ckrajkumar/nic2025_openDVS/analog/klayout/production/final_merge_20260923/audit_20260924/AUDIT_r21b_2026-09-24.md

# Audit of the submitted GDS r21b (sha fe196d31…) — 2026-09-24

Scope: full-layer XOR vs the collaborators' original (project_final), Magic DRC per rule, native FEOL/BEOL/offgrid,
metal-only connectivity of every analog macro pin vs gate-level verilog (r21b + original), LVS mismatch
classification with a baseline LVS of the untouched original + its own reference netlists. No GDS changed, no mail.
Scratch: ws ~/opendvs_final/audit_{lvs,conn,drc}/, project_audit_orig/.

## Changes vs original (XOR, 65 layers + labels, hierarchical + flat)
Only three sources, nothing else anywhere (0 polygons, 0 labels):
- pixel_4tile subtree (9 cells) + pixel_test_structure (2 cells): r19 pixel merge. 3 cells dropped (m1_m2_density_tile, vias_gen$3/$4).
- top met4 ×20 stripes / met5 ×20 stubs: r20 power joins.
- top via2 + met2 pad at 403.4–403.77 × 2622.28–2622.56: r21b rx fix.
Placements, cell count of the rest, layers: identical.

## Issues
| # | Issue | Where | Source | Severity | Action |
|---|---|---|---|---|---|
| 1 | rx (master-bias reference) floating | BiasBranchnMasterx11 rx, 404.35,2622.95 | collaborators' router | critical | fixed in r21b |
| 2 | Magic DRC 77 769 (r19) → 180 025 (r21b); all new items in pixel_4tile edge bands where r20 met4/met5 enter the tile bbox (abut/overlap 117 658, li.3, met1/2/3/5.2, capm.11) | pixel_4tile y 728–800 / 2200–2261, x 1212–1330 / 2630–2743 | us (r20) — Magic hierarchical artefact | low (real geometry), medium (optics if ChipFoundry reports Magic counts) | 280 sampled items: 0 real in flat KLayout; native BEOL deck 0. If flagged, answer with KLayout deck 0; optional flat Magic DRC of the bands |
| 3 | FEOL licon.17 + licon.13_a, 3528 items under KLayout 0.30 | GS_pixel_layout_tile(_bot) periphery | collaborators (identical in original; 0 under precheck's KLayout 0.29) | info | none |
| 4 | orphan `nRst` met1 label (no met1 under it) in every pixel | GS_openDVS_pixel (10.22,6.13); S7_openDVS_pixel | us (r19) | low (LVS unaffected) | delete in any future revision |
| 5 | `GND` met2 label off its met2.pin | GS_pixel_layout_tile_bot (2.82,15.67) | us (r19 row feeds) | low | same |
| 6 | stray labels on unconnected metal: BiasCB4, BufferN | LJ_BiasCoarseMBDivider, LJ_BiasBranch(Buffer) | collaborators | low (causes LVS lines) | none |
| 7 | labels vdda1/vssa1 on vdda2/vssa2 metal | photodiode_test_structure 276.14,1031.55 / 273.44,1031.12 | collaborators | low (no short) | none |
| 8 | Bias[10] unconnected | BiasBranchnMasterx11 593.58,3188.90 | design (dac_bias[10] unused) | info | none |
| 9 | repo LVS reference netlists = old pixel (.orig) | nic repo lvs/user_project_wrapper/ | collaborators' repo | medium (process: any LVS rerun from their repo fails on the pixel) | replace with our pixel_4tile/test-structure netlists |
| 10 | antenna (Magic antennacheck, PDK ratios, 220 600 gates) | r21b 14 violations = 9 met1 + 4 met2 + 1 met3, all on digital std-cell gates (ratios 428–854, limit 400), item-for-item identical to the original | collaborators' digital P&R | low–medium (pre-existing, their flow; typical sky130 ratio margins) | none from us; original also had 2 met3 violations on the test-structure pixels (openDVS_pixel_1/_2 at ~567,1041 µm, ratio 802/853) that r21b no longer has — removed by our pixel |

## LVS (114 Mismatch lines) — all benign
Baseline (original GDS + its reference netlists): same "Subcell(s) failed matching", 116 lines, same 16 groups.
- pixel/2x2/tile net counts: hierarchy-boundary splits (VddA18 on X14 source, 34 DiffBn tile ports → dac_config_0); flattened pixel_4tile + test structure match uniquely.
- pixel_4tile vssc1/vdda1/VSUBS: naming; 376 960 devices / 181 264 nets both sides.
- LJ_Bias*: topology-paired port names + stray labels (#6). BiasBranchnMasterx11 452/453: BiasCB4 piece; flat netgen match uniquely.
- top 28 814 vs 29 262 nets + ~70 port lines: implicit unconnected outputs, tie-off pairing; pin map of 48 751 instances vs verilog: 0 differences.
- vssa1/vssa2/vssd1 merged through the p-substrate in the Magic extraction (baseline too; separate in metal).
- pixel_4tile vs SCHEMATIC: ini ~/netgen_r19/comp.out "Circuits match uniquely"; r21b tile subtree identical to that r19 tile.

## Connectivity
1216 macro pin connections vs verilog: only defect in either GDS = #1. 8 power nets each single, no shorts, all macro rails reached.
