ckrajkumar/nic2025_openDVS/analog/klayout/production/final_merge_20260923/r19/power_sw_zoom.png

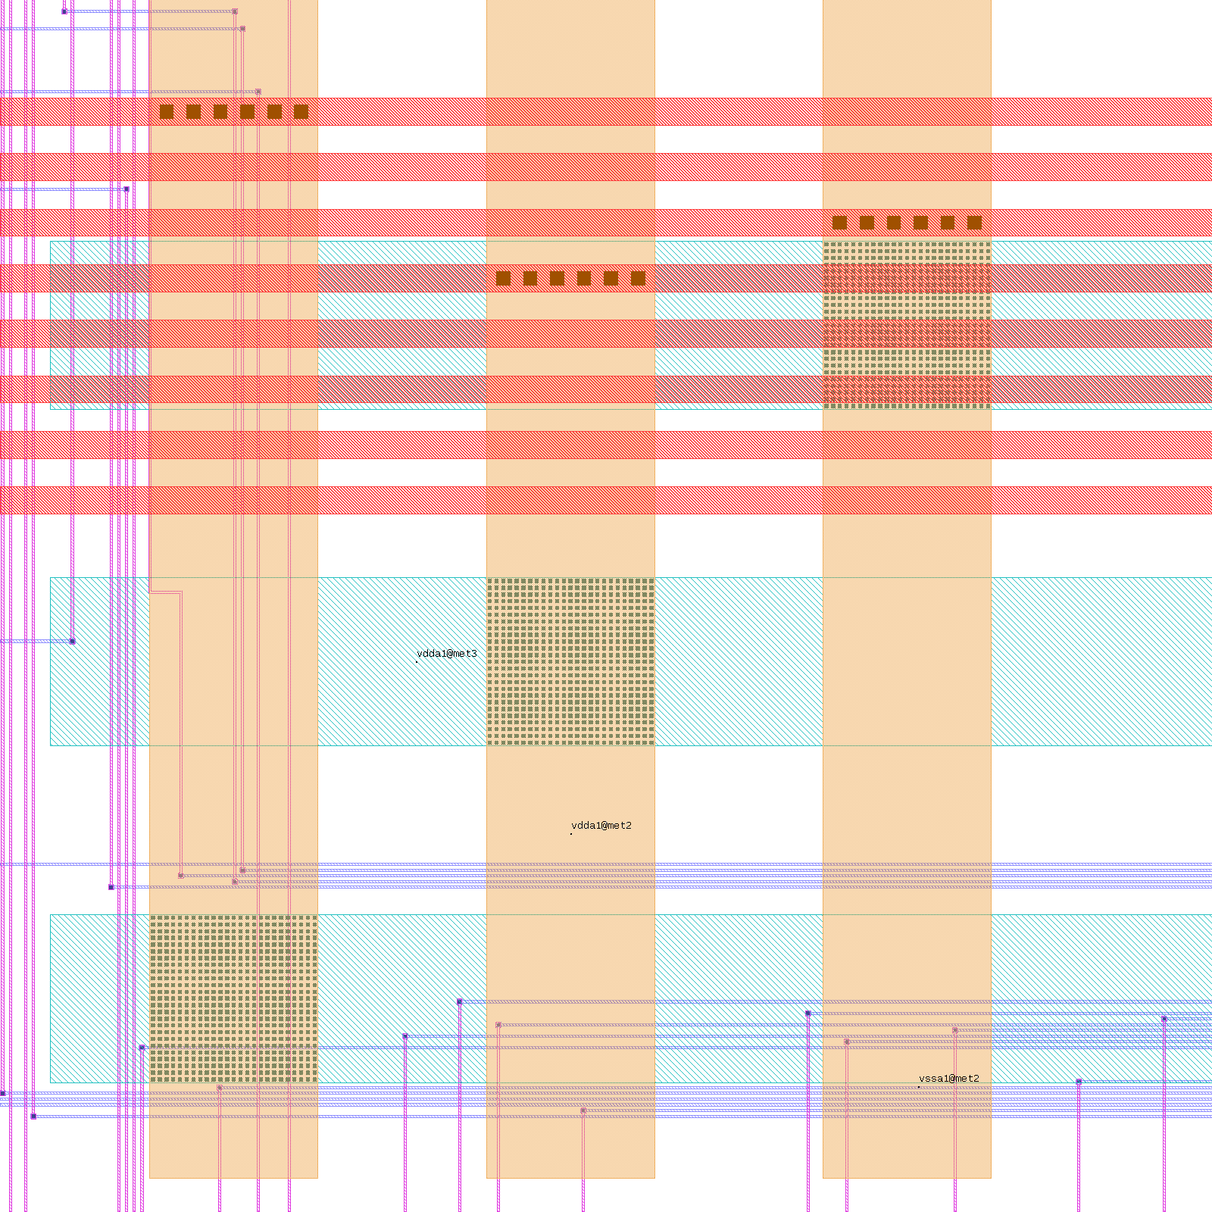
analog/klayout/production/final_merge_20260923/r19/power_sw_zoom.png
