ckrajkumar/nic2025_openDVS/analog/netlist/schematic/lvs_runs/_tmp/BiasBranchnMasterx11_schem_lvs_renamed.spice

** sch_path: /home/alienfalcon/Projects/skywater/open_dvs_py312/open_dvs/git_dvs/nic2025_openDVS/analog/xschem/BiasBranchnMasterx11_layout.sch
.subckt BiasBranchnMasterx11_schem VddA18 GndA rx Bias[10] Bias[9] Bias[8] Bias[7] Bias[6] Bias[5] Bias[4] Bias[3] Bias[2]
+ Bias[1] Bias[0] FineCodeBuffer[7] FineCodeBuffer[6] FineCodeBuffer[5] FineCodeBuffer[4] FineCodeBuffer[3] FineCodeBuffer[2]
+ FineCodeBuffer[1] FineCodeBuffer[0] CoarseOneHot[87] CoarseOneHot[86] CoarseOneHot[85] CoarseOneHot[84] CoarseOneHot[83] CoarseOneHot[82]
+ CoarseOneHot[81] CoarseOneHot[80] CoarseOneHot[79] CoarseOneHot[78] CoarseOneHot[77] CoarseOneHot[76] CoarseOneHot[75] CoarseOneHot[74]
+ CoarseOneHot[73] CoarseOneHot[72] CoarseOneHot[71] CoarseOneHot[70] CoarseOneHot[69] CoarseOneHot[68] CoarseOneHot[67] CoarseOneHot[66]
+ CoarseOneHot[65] CoarseOneHot[64] CoarseOneHot[63] CoarseOneHot[62] CoarseOneHot[61] CoarseOneHot[60] CoarseOneHot[59] CoarseOneHot[58]
+ CoarseOneHot[57] CoarseOneHot[56] CoarseOneHot[55] CoarseOneHot[54] CoarseOneHot[53] CoarseOneHot[52] CoarseOneHot[51] CoarseOneHot[50]
+ CoarseOneHot[49] CoarseOneHot[48] CoarseOneHot[47] CoarseOneHot[46] CoarseOneHot[45] CoarseOneHot[44] CoarseOneHot[43] CoarseOneHot[42]
+ CoarseOneHot[41] CoarseOneHot[40] CoarseOneHot[39] CoarseOneHot[38] CoarseOneHot[37] CoarseOneHot[36] CoarseOneHot[35] CoarseOneHot[34]
+ CoarseOneHot[33] CoarseOneHot[32] CoarseOneHot[31] CoarseOneHot[30] CoarseOneHot[29] CoarseOneHot[28] CoarseOneHot[27] CoarseOneHot[26]
+ CoarseOneHot[25] CoarseOneHot[24] CoarseOneHot[23] CoarseOneHot[22] CoarseOneHot[21] CoarseOneHot[20] CoarseOneHot[19] CoarseOneHot[18]
+ CoarseOneHot[17] CoarseOneHot[16] CoarseOneHot[15] CoarseOneHot[14] CoarseOneHot[13] CoarseOneHot[12] CoarseOneHot[11] CoarseOneHot[10]
+ CoarseOneHot[9] CoarseOneHot[8] CoarseOneHot[7] CoarseOneHot[6] CoarseOneHot[5] CoarseOneHot[4] CoarseOneHot[3] CoarseOneHot[2] CoarseOneHot[1]
+ CoarseOneHot[0] nFineCodeBuffer[7] nFineCodeBuffer[6] nFineCodeBuffer[5] nFineCodeBuffer[4] nFineCodeBuffer[3] nFineCodeBuffer[2]
+ nFineCodeBuffer[1] nFineCodeBuffer[0] CoarseOneHotBuffer[7] CoarseOneHotBuffer[6] CoarseOneHotBuffer[5] CoarseOneHotBuffer[4] CoarseOneHotBuffer[3]
+ CoarseOneHotBuffer[2] CoarseOneHotBuffer[1] CoarseOneHotBuffer[0] LowBiasInterfaceEn[10] LowBiasInterfaceEn[9] LowBiasInterfaceEn[8]
+ LowBiasInterfaceEn[7] LowBiasInterfaceEn[6] LowBiasInterfaceEn[5] LowBiasInterfaceEn[4] LowBiasInterfaceEn[3] LowBiasInterfaceEn[2]
+ LowBiasInterfaceEn[1] LowBiasInterfaceEn[0] nLowBiasInterfaceEn[10] nLowBiasInterfaceEn[9] nLowBiasInterfaceEn[8] nLowBiasInterfaceEn[7]
+ nLowBiasInterfaceEn[6] nLowBiasInterfaceEn[5] nLowBiasInterfaceEn[4] nLowBiasInterfaceEn[3] nLowBiasInterfaceEn[2] nLowBiasInterfaceEn[1]
+ nLowBiasInterfaceEn[0] CoarseOneHotLowBiasEn[10] CoarseOneHotLowBiasEn[9] CoarseOneHotLowBiasEn[8] CoarseOneHotLowBiasEn[7] CoarseOneHotLowBiasEn[6]
+ CoarseOneHotLowBiasEn[5] CoarseOneHotLowBiasEn[4] CoarseOneHotLowBiasEn[3] CoarseOneHotLowBiasEn[2] CoarseOneHotLowBiasEn[1] CoarseOneHotLowBiasEn[0]
+ BIT0[10] BIT0[9] BIT0[8] BIT0[7] BIT0[6] BIT0[5] BIT0[4] BIT0[3] BIT0[2] BIT0[1] BIT0[0] PowerDown[10] PowerDown[9] PowerDown[8]
+ PowerDown[7] PowerDown[6] PowerDown[5] PowerDown[4] PowerDown[3] PowerDown[2] PowerDown[1] PowerDown[0] LowBiasInterfaceEnBuffer
+ nLowBiasInterfaceEnBuffer CoarseOneHotLowBiasEnBuffer PowerDownM NBiasEn[10] NBiasEn[9] NBiasEn[8] NBiasEn[7] NBiasEn[6] NBiasEn[5] NBiasEn[4] NBiasEn[3]
+ NBiasEn[2] NBiasEn[1] NBiasEn[0] PBiasEn[10] PBiasEn[9] PBiasEn[8] PBiasEn[7] PBiasEn[6] PBiasEn[5] PBiasEn[4] PBiasEn[3] PBiasEn[2]
+ PBiasEn[1] PBiasEn[0] BiasDisabled[10] BiasDisabled[9] BiasDisabled[8] BiasDisabled[7] BiasDisabled[6] BiasDisabled[5] BiasDisabled[4]
+ BiasDisabled[3] BiasDisabled[2] BiasDisabled[1] BiasDisabled[0] FineCode[87] FineCode[86] FineCode[85] FineCode[84] FineCode[83] FineCode[82]
+ FineCode[81] FineCode[80] FineCode[79] FineCode[78] FineCode[77] FineCode[76] FineCode[75] FineCode[74] FineCode[73] FineCode[72] FineCode[71]
+ FineCode[70] FineCode[69] FineCode[68] FineCode[67] FineCode[66] FineCode[65] FineCode[64] FineCode[63] FineCode[62] FineCode[61] FineCode[60]
+ FineCode[59] FineCode[58] FineCode[57] FineCode[56] FineCode[55] FineCode[54] FineCode[53] FineCode[52] FineCode[51] FineCode[50] FineCode[49]
+ FineCode[48] FineCode[47] FineCode[46] FineCode[45] FineCode[44] FineCode[43] FineCode[42] FineCode[41] FineCode[40] FineCode[39] FineCode[38]
+ FineCode[37] FineCode[36] FineCode[35] FineCode[34] FineCode[33] FineCode[32] FineCode[31] FineCode[30] FineCode[29] FineCode[28] FineCode[27]
+ FineCode[26] FineCode[25] FineCode[24] FineCode[23] FineCode[22] FineCode[21] FineCode[20] FineCode[19] FineCode[18] FineCode[17] FineCode[16]
+ FineCode[15] FineCode[14] FineCode[13] FineCode[12] FineCode[11] FineCode[10] FineCode[9] FineCode[8] FineCode[7] FineCode[6] FineCode[5]
+ FineCode[4] FineCode[3] FineCode[2] FineCode[1] FineCode[0] nFineCode[87] nFineCode[86] nFineCode[85] nFineCode[84] nFineCode[83]
+ nFineCode[82] nFineCode[81] nFineCode[80] nFineCode[79] nFineCode[78] nFineCode[77] nFineCode[76] nFineCode[75] nFineCode[74] nFineCode[73]
+ nFineCode[72] nFineCode[71] nFineCode[70] nFineCode[69] nFineCode[68] nFineCode[67] nFineCode[66] nFineCode[65] nFineCode[64] nFineCode[63]
+ nFineCode[62] nFineCode[61] nFineCode[60] nFineCode[59] nFineCode[58] nFineCode[57] nFineCode[56] nFineCode[55] nFineCode[54] nFineCode[53]
+ nFineCode[52] nFineCode[51] nFineCode[50] nFineCode[49] nFineCode[48] nFineCode[47] nFineCode[46] nFineCode[45] nFineCode[44] nFineCode[43]
+ nFineCode[42] nFineCode[41] nFineCode[40] nFineCode[39] nFineCode[38] nFineCode[37] nFineCode[36] nFineCode[35] nFineCode[34] nFineCode[33]
+ nFineCode[32] nFineCode[31] nFineCode[30] nFineCode[29] nFineCode[28] nFineCode[27] nFineCode[26] nFineCode[25] nFineCode[24] nFineCode[23]
+ nFineCode[22] nFineCode[21] nFineCode[20] nFineCode[19] nFineCode[18] nFineCode[17] nFineCode[16] nFineCode[15] nFineCode[14] nFineCode[13]
+ nFineCode[12] nFineCode[11] nFineCode[10] nFineCode[9] nFineCode[8] nFineCode[7] nFineCode[6] nFineCode[5] nFineCode[4] nFineCode[3]
+ nFineCode[2] nFineCode[1] nFineCode[0] PadBias[10] PadBias[9] PadBias[8] PadBias[7] PadBias[6] PadBias[5] PadBias[4] PadBias[3] PadBias[2]
+ PadBias[1] PadBias[0]
*.PININFO VddA18:B GndA:B rx:B Bias[10:0]:O FineCodeBuffer[7:0]:I CoarseOneHot[87:0]:I nFineCodeBuffer[7:0]:I
*+ CoarseOneHotBuffer[7:0]:I LowBiasInterfaceEn[10:0]:I nLowBiasInterfaceEn[10:0]:I CoarseOneHotLowBiasEn[10:0]:I BIT0[10:0]:I PowerDown[10:0]:I
*+ LowBiasInterfaceEnBuffer:I nLowBiasInterfaceEnBuffer:I CoarseOneHotLowBiasEnBuffer:I PowerDownM:I NBiasEn[10:0]:I PBiasEn[10:0]:I BiasDisabled[10:0]:I
*+ FineCode[87:0]:I nFineCode[87:0]:I PadBias[10:0]:B
x1 VddA18 GndA Bias[10] Bias[9] Bias[8] Bias[7] Bias[6] Bias[5] Bias[4] Bias[3] Bias[2] Bias[1] Bias[0] PowerDownM rx PadBias[10]
+ PadBias[9] PadBias[8] PadBias[7] PadBias[6] PadBias[5] PadBias[4] PadBias[3] PadBias[2] PadBias[1] PadBias[0] FineCodeBuffer[7]
+ FineCodeBuffer[6] FineCodeBuffer[5] FineCodeBuffer[4] FineCodeBuffer[3] FineCodeBuffer[2] FineCodeBuffer[1] FineCodeBuffer[0] FineCode[10]
+ FineCode[9] FineCode[8] FineCode[7] FineCode[6] FineCode[5] FineCode[4] FineCode[3] FineCode[2] FineCode[1] FineCode[0] nFineCodeBuffer[7]
+ nFineCodeBuffer[6] nFineCodeBuffer[5] nFineCodeBuffer[4] nFineCodeBuffer[3] nFineCodeBuffer[2] nFineCodeBuffer[1] nFineCodeBuffer[0] FineCode[21]
+ FineCode[20] FineCode[19] FineCode[18] FineCode[17] FineCode[16] FineCode[15] FineCode[14] FineCode[13] FineCode[12] FineCode[11]
+ CoarseOneHotBuffer[7] CoarseOneHotBuffer[6] CoarseOneHotBuffer[5] CoarseOneHotBuffer[4] CoarseOneHotBuffer[3] CoarseOneHotBuffer[2]
+ CoarseOneHotBuffer[1] CoarseOneHotBuffer[0] LowBiasInterfaceEnBuffer FineCode[32] FineCode[31] FineCode[30] FineCode[29] FineCode[28] FineCode[27]
+ FineCode[26] FineCode[25] FineCode[24] FineCode[23] FineCode[22] FineCode[43] FineCode[42] FineCode[41] FineCode[40] FineCode[39] FineCode[38]
+ FineCode[37] FineCode[36] FineCode[35] FineCode[34] FineCode[33] nLowBiasInterfaceEnBuffer FineCode[54] FineCode[53] FineCode[52] FineCode[51]
+ FineCode[50] FineCode[49] FineCode[48] FineCode[47] FineCode[46] FineCode[45] FineCode[44] CoarseOneHotLowBiasEnBuffer FineCode[65]
+ FineCode[64] FineCode[63] FineCode[62] FineCode[61] FineCode[60] FineCode[59] FineCode[58] FineCode[57] FineCode[56] FineCode[55] FineCode[76]
+ FineCode[75] FineCode[74] FineCode[73] FineCode[72] FineCode[71] FineCode[70] FineCode[69] FineCode[68] FineCode[67] FineCode[66] FineCode[87]
+ FineCode[86] FineCode[85] FineCode[84] FineCode[83] FineCode[82] FineCode[81] FineCode[80] FineCode[79] FineCode[78] FineCode[77]
+ nFineCode[10] nFineCode[9] nFineCode[8] nFineCode[7] nFineCode[6] nFineCode[5] nFineCode[4] nFineCode[3] nFineCode[2] nFineCode[1] nFineCode[0]
+ nFineCode[21] nFineCode[20] nFineCode[19] nFineCode[18] nFineCode[17] nFineCode[16] nFineCode[15] nFineCode[14] nFineCode[13] nFineCode[12]
+ nFineCode[11] nFineCode[32] nFineCode[31] nFineCode[30] nFineCode[29] nFineCode[28] nFineCode[27] nFineCode[26] nFineCode[25] nFineCode[24]
+ nFineCode[23] nFineCode[22] nFineCode[43] nFineCode[42] nFineCode[41] nFineCode[40] nFineCode[39] nFineCode[38] nFineCode[37] nFineCode[36]
+ nFineCode[35] nFineCode[34] nFineCode[33] nFineCode[54] nFineCode[53] nFineCode[52] nFineCode[51] nFineCode[50] nFineCode[49] nFineCode[48]
+ nFineCode[47] nFineCode[46] nFineCode[45] nFineCode[44] nFineCode[65] nFineCode[64] nFineCode[63] nFineCode[62] nFineCode[61] nFineCode[60]
+ nFineCode[59] nFineCode[58] nFineCode[57] nFineCode[56] nFineCode[55] nFineCode[76] nFineCode[75] nFineCode[74] nFineCode[73] nFineCode[72]
+ nFineCode[71] nFineCode[70] nFineCode[69] nFineCode[68] nFineCode[67] nFineCode[66] nFineCode[87] nFineCode[86] nFineCode[85] nFineCode[84]
+ nFineCode[83] nFineCode[82] nFineCode[81] nFineCode[80] nFineCode[79] nFineCode[78] nFineCode[77] CoarseOneHot[10] CoarseOneHot[9]
+ CoarseOneHot[8] CoarseOneHot[7] CoarseOneHot[6] CoarseOneHot[5] CoarseOneHot[4] CoarseOneHot[3] CoarseOneHot[2] CoarseOneHot[1] CoarseOneHot[0]
+ CoarseOneHot[21] CoarseOneHot[20] CoarseOneHot[19] CoarseOneHot[18] CoarseOneHot[17] CoarseOneHot[16] CoarseOneHot[15] CoarseOneHot[14]
+ CoarseOneHot[13] CoarseOneHot[12] CoarseOneHot[11] CoarseOneHot[32] CoarseOneHot[31] CoarseOneHot[30] CoarseOneHot[29] CoarseOneHot[28]
+ CoarseOneHot[27] CoarseOneHot[26] CoarseOneHot[25] CoarseOneHot[24] CoarseOneHot[23] CoarseOneHot[22] CoarseOneHot[43] CoarseOneHot[42]
+ CoarseOneHot[41] CoarseOneHot[40] CoarseOneHot[39] CoarseOneHot[38] CoarseOneHot[37] CoarseOneHot[36] CoarseOneHot[35] CoarseOneHot[34]
+ CoarseOneHot[33] CoarseOneHot[54] CoarseOneHot[53] CoarseOneHot[52] CoarseOneHot[51] CoarseOneHot[50] CoarseOneHot[49] CoarseOneHot[48]
+ CoarseOneHot[47] CoarseOneHot[46] CoarseOneHot[45] CoarseOneHot[44] CoarseOneHot[65] CoarseOneHot[64] CoarseOneHot[63] CoarseOneHot[62]
+ CoarseOneHot[61] CoarseOneHot[60] CoarseOneHot[59] CoarseOneHot[58] CoarseOneHot[57] CoarseOneHot[56] CoarseOneHot[55] CoarseOneHot[76]
+ CoarseOneHot[75] CoarseOneHot[74] CoarseOneHot[73] CoarseOneHot[72] CoarseOneHot[71] CoarseOneHot[70] CoarseOneHot[69] CoarseOneHot[68]
+ CoarseOneHot[67] CoarseOneHot[66] CoarseOneHot[87] CoarseOneHot[86] CoarseOneHot[85] CoarseOneHot[84] CoarseOneHot[83] CoarseOneHot[82]
+ CoarseOneHot[81] CoarseOneHot[80] CoarseOneHot[79] CoarseOneHot[78] CoarseOneHot[77] LowBiasInterfaceEn[10] LowBiasInterfaceEn[9]
+ LowBiasInterfaceEn[8] LowBiasInterfaceEn[7] LowBiasInterfaceEn[6] LowBiasInterfaceEn[5] LowBiasInterfaceEn[4] LowBiasInterfaceEn[3]
+ LowBiasInterfaceEn[2] LowBiasInterfaceEn[1] LowBiasInterfaceEn[0] nLowBiasInterfaceEn[10] nLowBiasInterfaceEn[9] nLowBiasInterfaceEn[8]
+ nLowBiasInterfaceEn[7] nLowBiasInterfaceEn[6] nLowBiasInterfaceEn[5] nLowBiasInterfaceEn[4] nLowBiasInterfaceEn[3] nLowBiasInterfaceEn[2]
+ nLowBiasInterfaceEn[1] nLowBiasInterfaceEn[0] CoarseOneHotLowBiasEn[10] CoarseOneHotLowBiasEn[9] CoarseOneHotLowBiasEn[8] CoarseOneHotLowBiasEn[7]
+ CoarseOneHotLowBiasEn[6] CoarseOneHotLowBiasEn[5] CoarseOneHotLowBiasEn[4] CoarseOneHotLowBiasEn[3] CoarseOneHotLowBiasEn[2] CoarseOneHotLowBiasEn[1]
+ CoarseOneHotLowBiasEn[0] BIT0[10] BIT0[9] BIT0[8] BIT0[7] BIT0[6] BIT0[5] BIT0[4] BIT0[3] BIT0[2] BIT0[1] BIT0[0] PowerDown[10] PowerDown[9] PowerDown[8]
+ PowerDown[7] PowerDown[6] PowerDown[5] PowerDown[4] PowerDown[3] PowerDown[2] PowerDown[1] PowerDown[0] NBiasEn[10] NBiasEn[9] NBiasEn[8]
+ NBiasEn[7] NBiasEn[6] NBiasEn[5] NBiasEn[4] NBiasEn[3] NBiasEn[2] NBiasEn[1] NBiasEn[0] PBiasEn[10] PBiasEn[9] PBiasEn[8] PBiasEn[7]
+ PBiasEn[6] PBiasEn[5] PBiasEn[4] PBiasEn[3] PBiasEn[2] PBiasEn[1] PBiasEn[0] BiasDisabled[10] BiasDisabled[9] BiasDisabled[8]
+ BiasDisabled[7] BiasDisabled[6] BiasDisabled[5] BiasDisabled[4] BiasDisabled[3] BiasDisabled[2] BiasDisabled[1] BiasDisabled[0]
+ BiasBranchnMasterx11
.ends

* expanding   symbol:  BiasBranchnMasterx11.sym # of pins=45
** sym_path: /home/alienfalcon/Projects/skywater/open_dvs_py312/open_dvs/git_dvs/nic2025_openDVS/analog/xschem/BiasBranchnMasterx11.sym
** sch_path: /home/alienfalcon/Projects/skywater/open_dvs_py312/open_dvs/git_dvs/nic2025_openDVS/analog/xschem/BiasBranchnMasterx11.sch
.subckt BiasBranchnMasterx11 VddA18 GndA Bias[10] Bias[9] Bias[8] Bias[7] Bias[6] Bias[5] Bias[4] Bias[3] Bias[2] Bias[1] Bias[0]
+ PowerDownM rx PadBias[10] PadBias[9] PadBias[8] PadBias[7] PadBias[6] PadBias[5] PadBias[4] PadBias[3] PadBias[2] PadBias[1] PadBias[0]
+ FineCodeBuffer[7] FineCodeBuffer[6] FineCodeBuffer[5] FineCodeBuffer[4] FineCodeBuffer[3] FineCodeBuffer[2] FineCodeBuffer[1] FineCodeBuffer[0]
+ FineCode[10] FineCode[9] FineCode[8] FineCode[7] FineCode[6] FineCode[5] FineCode[4] FineCode[3] FineCode[2] FineCode[1] FineCode[0]
+ nFineCodeBuffer[7] nFineCodeBuffer[6] nFineCodeBuffer[5] nFineCodeBuffer[4] nFineCodeBuffer[3] nFineCodeBuffer[2] nFineCodeBuffer[1]
+ nFineCodeBuffer[0] FineCode[21] FineCode[20] FineCode[19] FineCode[18] FineCode[17] FineCode[16] FineCode[15] FineCode[14] FineCode[13] FineCode[12]
+ FineCode[11] CoarseOneHotBuffer[7] CoarseOneHotBuffer[6] CoarseOneHotBuffer[5] CoarseOneHotBuffer[4] CoarseOneHotBuffer[3]
+ CoarseOneHotBuffer[2] CoarseOneHotBuffer[1] CoarseOneHotBuffer[0] LowBiasInterfaceEnBuffer FineCode[32] FineCode[31] FineCode[30] FineCode[29]
+ FineCode[28] FineCode[27] FineCode[26] FineCode[25] FineCode[24] FineCode[23] FineCode[22] FineCode[43] FineCode[42] FineCode[41] FineCode[40]
+ FineCode[39] FineCode[38] FineCode[37] FineCode[36] FineCode[35] FineCode[34] FineCode[33] nLowBiasInterfaceEnBuffer FineCode[54] FineCode[53]
+ FineCode[52] FineCode[51] FineCode[50] FineCode[49] FineCode[48] FineCode[47] FineCode[46] FineCode[45] FineCode[44]
+ CoarseOneHotLowBiasEnBuffer FineCode[65] FineCode[64] FineCode[63] FineCode[62] FineCode[61] FineCode[60] FineCode[59] FineCode[58] FineCode[57] FineCode[56]
+ FineCode[55] FineCode[76] FineCode[75] FineCode[74] FineCode[73] FineCode[72] FineCode[71] FineCode[70] FineCode[69] FineCode[68] FineCode[67]
+ FineCode[66] FineCode[87] FineCode[86] FineCode[85] FineCode[84] FineCode[83] FineCode[82] FineCode[81] FineCode[80] FineCode[79] FineCode[78]
+ FineCode[77] nFineCode[10] nFineCode[9] nFineCode[8] nFineCode[7] nFineCode[6] nFineCode[5] nFineCode[4] nFineCode[3] nFineCode[2]
+ nFineCode[1] nFineCode[0] nFineCode[21] nFineCode[20] nFineCode[19] nFineCode[18] nFineCode[17] nFineCode[16] nFineCode[15] nFineCode[14]
+ nFineCode[13] nFineCode[12] nFineCode[11] nFineCode[32] nFineCode[31] nFineCode[30] nFineCode[29] nFineCode[28] nFineCode[27] nFineCode[26]
+ nFineCode[25] nFineCode[24] nFineCode[23] nFineCode[22] nFineCode[43] nFineCode[42] nFineCode[41] nFineCode[40] nFineCode[39] nFineCode[38]
+ nFineCode[37] nFineCode[36] nFineCode[35] nFineCode[34] nFineCode[33] nFineCode[54] nFineCode[53] nFineCode[52] nFineCode[51] nFineCode[50]
+ nFineCode[49] nFineCode[48] nFineCode[47] nFineCode[46] nFineCode[45] nFineCode[44] nFineCode[65] nFineCode[64] nFineCode[63] nFineCode[62]
+ nFineCode[61] nFineCode[60] nFineCode[59] nFineCode[58] nFineCode[57] nFineCode[56] nFineCode[55] nFineCode[76] nFineCode[75] nFineCode[74]
+ nFineCode[73] nFineCode[72] nFineCode[71] nFineCode[70] nFineCode[69] nFineCode[68] nFineCode[67] nFineCode[66] nFineCode[87] nFineCode[86]
+ nFineCode[85] nFineCode[84] nFineCode[83] nFineCode[82] nFineCode[81] nFineCode[80] nFineCode[79] nFineCode[78] nFineCode[77] CoarseOneHot[10]
+ CoarseOneHot[9] CoarseOneHot[8] CoarseOneHot[7] CoarseOneHot[6] CoarseOneHot[5] CoarseOneHot[4] CoarseOneHot[3] CoarseOneHot[2] CoarseOneHot[1]
+ CoarseOneHot[0] CoarseOneHot[21] CoarseOneHot[20] CoarseOneHot[19] CoarseOneHot[18] CoarseOneHot[17] CoarseOneHot[16] CoarseOneHot[15]
+ CoarseOneHot[14] CoarseOneHot[13] CoarseOneHot[12] CoarseOneHot[11] CoarseOneHot[32] CoarseOneHot[31] CoarseOneHot[30] CoarseOneHot[29]
+ CoarseOneHot[28] CoarseOneHot[27] CoarseOneHot[26] CoarseOneHot[25] CoarseOneHot[24] CoarseOneHot[23] CoarseOneHot[22] CoarseOneHot[43]
+ CoarseOneHot[42] CoarseOneHot[41] CoarseOneHot[40] CoarseOneHot[39] CoarseOneHot[38] CoarseOneHot[37] CoarseOneHot[36] CoarseOneHot[35]
+ CoarseOneHot[34] CoarseOneHot[33] CoarseOneHot[54] CoarseOneHot[53] CoarseOneHot[52] CoarseOneHot[51] CoarseOneHot[50] CoarseOneHot[49]
+ CoarseOneHot[48] CoarseOneHot[47] CoarseOneHot[46] CoarseOneHot[45] CoarseOneHot[44] CoarseOneHot[65] CoarseOneHot[64] CoarseOneHot[63]
+ CoarseOneHot[62] CoarseOneHot[61] CoarseOneHot[60] CoarseOneHot[59] CoarseOneHot[58] CoarseOneHot[57] CoarseOneHot[56] CoarseOneHot[55]
+ CoarseOneHot[76] CoarseOneHot[75] CoarseOneHot[74] CoarseOneHot[73] CoarseOneHot[72] CoarseOneHot[71] CoarseOneHot[70] CoarseOneHot[69]
+ CoarseOneHot[68] CoarseOneHot[67] CoarseOneHot[66] CoarseOneHot[87] CoarseOneHot[86] CoarseOneHot[85] CoarseOneHot[84] CoarseOneHot[83]
+ CoarseOneHot[82] CoarseOneHot[81] CoarseOneHot[80] CoarseOneHot[79] CoarseOneHot[78] CoarseOneHot[77] LowBiasInterfaceEn[10] LowBiasInterfaceEn[9]
+ LowBiasInterfaceEn[8] LowBiasInterfaceEn[7] LowBiasInterfaceEn[6] LowBiasInterfaceEn[5] LowBiasInterfaceEn[4] LowBiasInterfaceEn[3]
+ LowBiasInterfaceEn[2] LowBiasInterfaceEn[1] LowBiasInterfaceEn[0] nLowBiasInterfaceEn[10] nLowBiasInterfaceEn[9] nLowBiasInterfaceEn[8]
+ nLowBiasInterfaceEn[7] nLowBiasInterfaceEn[6] nLowBiasInterfaceEn[5] nLowBiasInterfaceEn[4] nLowBiasInterfaceEn[3] nLowBiasInterfaceEn[2]
+ nLowBiasInterfaceEn[1] nLowBiasInterfaceEn[0] CoarseOneHotLowBiasEn[10] CoarseOneHotLowBiasEn[9] CoarseOneHotLowBiasEn[8] CoarseOneHotLowBiasEn[7]
+ CoarseOneHotLowBiasEn[6] CoarseOneHotLowBiasEn[5] CoarseOneHotLowBiasEn[4] CoarseOneHotLowBiasEn[3] CoarseOneHotLowBiasEn[2] CoarseOneHotLowBiasEn[1]
+ CoarseOneHotLowBiasEn[0] BIT0[10] BIT0[9] BIT0[8] BIT0[7] BIT0[6] BIT0[5] BIT0[4] BIT0[3] BIT0[2] BIT0[1] BIT0[0] PowerDown[10] PowerDown[9] PowerDown[8]
+ PowerDown[7] PowerDown[6] PowerDown[5] PowerDown[4] PowerDown[3] PowerDown[2] PowerDown[1] PowerDown[0] NBiasEn[10] NBiasEn[9] NBiasEn[8]
+ NBiasEn[7] NBiasEn[6] NBiasEn[5] NBiasEn[4] NBiasEn[3] NBiasEn[2] NBiasEn[1] NBiasEn[0] PBiasEn[10] PBiasEn[9] PBiasEn[8] PBiasEn[7]
+ PBiasEn[6] PBiasEn[5] PBiasEn[4] PBiasEn[3] PBiasEn[2] PBiasEn[1] PBiasEn[0] BiasDisabled[10] BiasDisabled[9] BiasDisabled[8]
+ BiasDisabled[7] BiasDisabled[6] BiasDisabled[5] BiasDisabled[4] BiasDisabled[3] BiasDisabled[2] BiasDisabled[1] BiasDisabled[0]
*.PININFO VddA18:B GndA:B rx:B Bias[10:0]:O FineCodeBuffer[7:0]:I nFineCodeBuffer[7:0]:I CoarseOneHotBuffer[7:0]:I
*+ LowBiasInterfaceEn[10:0]:B nLowBiasInterfaceEn[10:0]:B CoarseOneHotLowBiasEn[10:0]:B BIT0[10:0]:B PowerDown[10:0]:B LowBiasInterfaceEnBuffer:I
*+ nLowBiasInterfaceEnBuffer:I CoarseOneHotLowBiasEnBuffer:I PowerDownM:I NBiasEn[10:0]:B PBiasEn[10:0]:B BiasDisabled[10:0]:B FineCode[87:0]:B
*+ nFineCode[87:0]:B CoarseOneHot[87:0]:B PadBias[10:0]:B PadBias[0]:B PadBias[1]:B PadBias[2]:B PadBias[3]:B PadBias[4]:B PadBias[5]:B PadBias[6]:B
*+ PadBias[7]:B PadBias[8]:B PadBias[9]:B PadBias[10]:B
xBiasBranch VddA18 GndA BiasCB[7] BiasCB[6] BiasCB[5] BiasCB[4] BiasCB[3] BiasCB[2] BiasCB[1] BiasCB[0] BufferN BufferP Bias[0]
+ LowBiasInterfaceEn[0] nLowBiasInterfaceEn[0] FineCode[7] CoarseOneHotLowBiasEn[0] BIT0[0] NBiasEn[0] PBiasEn[0] BiasDisabled[0] FineCode[6] FineCode[5]
+ FineCode[4] FineCode[3] FineCode[2] FineCode[1] FineCode[0] nFineCode[7] nFineCode[6] nFineCode[5] nFineCode[4] nFineCode[3] nFineCode[2]
+ nFineCode[1] nFineCode[0] CoarseOneHot[7] CoarseOneHot[6] CoarseOneHot[5] CoarseOneHot[4] CoarseOneHot[3] CoarseOneHot[2] CoarseOneHot[1]
+ CoarseOneHot[0] PadBias[0] PowerDown[0] BiasBranch
xBiasMasternCoarse VddA18 GndA BiasCB[0] BiasCB[1] BiasCB[3] BiasCB[4] BiasCB[5] BiasCB[6] BiasCB[7] BiasCB[2] PowerDownM
+ VMasterBiasN VMasterBiasP rx BiasMasternCoarse
xBiasBuffer VddA18 GndA BiasCB[7] BiasCB[6] BiasCB[5] BiasCB[4] BiasCB[3] BiasCB[2] BiasCB[1] BiasCB[0] CoarseOneHotBuffer[7]
+ CoarseOneHotBuffer[6] CoarseOneHotBuffer[5] CoarseOneHotBuffer[4] CoarseOneHotBuffer[3] CoarseOneHotBuffer[2] CoarseOneHotBuffer[1]
+ CoarseOneHotBuffer[0] BufferN BufferP LowBiasInterfaceEnBuffer nLowBiasInterfaceEnBuffer FineCodeBuffer[7] FineCodeBuffer[6] FineCodeBuffer[5]
+ FineCodeBuffer[4] FineCodeBuffer[3] FineCodeBuffer[2] FineCodeBuffer[1] FineCodeBuffer[0] nFineCodeBuffer[7] nFineCodeBuffer[6] nFineCodeBuffer[5]
+ nFineCodeBuffer[4] nFineCodeBuffer[3] nFineCodeBuffer[2] nFineCodeBuffer[1] nFineCodeBuffer[0] CoarseOneHotLowBiasEnBuffer BiasBranchBuffer
xBiasBranch1 VddA18 GndA BiasCB[7] BiasCB[6] BiasCB[5] BiasCB[4] BiasCB[3] BiasCB[2] BiasCB[1] BiasCB[0] BufferN BufferP Bias[1]
+ LowBiasInterfaceEn[1] nLowBiasInterfaceEn[1] FineCode[15] CoarseOneHotLowBiasEn[1] BIT0[1] NBiasEn[1] PBiasEn[1] BiasDisabled[1] FineCode[14]
+ FineCode[13] FineCode[12] FineCode[11] FineCode[10] FineCode[9] FineCode[8] nFineCode[15] nFineCode[14] nFineCode[13] nFineCode[12]
+ nFineCode[11] nFineCode[10] nFineCode[9] nFineCode[8] CoarseOneHot[15] CoarseOneHot[14] CoarseOneHot[13] CoarseOneHot[12] CoarseOneHot[11]
+ CoarseOneHot[10] CoarseOneHot[9] CoarseOneHot[8] PadBias[1] PowerDown[1] BiasBranch
xBiasBranch2 VddA18 GndA BiasCB[7] BiasCB[6] BiasCB[5] BiasCB[4] BiasCB[3] BiasCB[2] BiasCB[1] BiasCB[0] BufferN BufferP Bias[2]
+ LowBiasInterfaceEn[2] nLowBiasInterfaceEn[2] FineCode[23] CoarseOneHotLowBiasEn[2] BIT0[2] NBiasEn[2] PBiasEn[2] BiasDisabled[2] FineCode[22]
+ FineCode[21] FineCode[20] FineCode[19] FineCode[18] FineCode[17] FineCode[16] nFineCode[23] nFineCode[22] nFineCode[21] nFineCode[20]
+ nFineCode[19] nFineCode[18] nFineCode[17] nFineCode[16] CoarseOneHot[23] CoarseOneHot[22] CoarseOneHot[21] CoarseOneHot[20] CoarseOneHot[19]
+ CoarseOneHot[18] CoarseOneHot[17] CoarseOneHot[16] PadBias[2] PowerDown[2] BiasBranch
xBiasBranch3 VddA18 GndA BiasCB[7] BiasCB[6] BiasCB[5] BiasCB[4] BiasCB[3] BiasCB[2] BiasCB[1] BiasCB[0] BufferN BufferP Bias[3]
+ LowBiasInterfaceEn[3] nLowBiasInterfaceEn[3] FineCode[31] CoarseOneHotLowBiasEn[3] BIT0[3] NBiasEn[3] PBiasEn[3] BiasDisabled[3] FineCode[30]
+ FineCode[29] FineCode[28] FineCode[27] FineCode[26] FineCode[25] FineCode[24] nFineCode[31] nFineCode[30] nFineCode[29] nFineCode[28]
+ nFineCode[27] nFineCode[26] nFineCode[25] nFineCode[24] CoarseOneHot[31] CoarseOneHot[30] CoarseOneHot[29] CoarseOneHot[28] CoarseOneHot[27]
+ CoarseOneHot[26] CoarseOneHot[25] CoarseOneHot[24] PadBias[3] PowerDown[3] BiasBranch
xBiasBranch4 VddA18 GndA BiasCB[7] BiasCB[6] BiasCB[5] BiasCB[4] BiasCB[3] BiasCB[2] BiasCB[1] BiasCB[0] BufferN BufferP Bias[4]
+ LowBiasInterfaceEn[4] nLowBiasInterfaceEn[4] FineCode[39] CoarseOneHotLowBiasEn[4] BIT0[4] NBiasEn[4] PBiasEn[4] BiasDisabled[4] FineCode[38]
+ FineCode[37] FineCode[36] FineCode[35] FineCode[34] FineCode[33] FineCode[32] nFineCode[39] nFineCode[38] nFineCode[37] nFineCode[36]
+ nFineCode[35] nFineCode[34] nFineCode[33] nFineCode[32] CoarseOneHot[39] CoarseOneHot[38] CoarseOneHot[37] CoarseOneHot[36] CoarseOneHot[35]
+ CoarseOneHot[34] CoarseOneHot[33] CoarseOneHot[32] PadBias[4] PowerDown[4] BiasBranch
xBiasBranch5 VddA18 GndA BiasCB[7] BiasCB[6] BiasCB[5] BiasCB[4] BiasCB[3] BiasCB[2] BiasCB[1] BiasCB[0] BufferN BufferP Bias[5]
+ LowBiasInterfaceEn[5] nLowBiasInterfaceEn[5] FineCode[47] CoarseOneHotLowBiasEn[5] BIT0[5] NBiasEn[5] PBiasEn[5] BiasDisabled[5] FineCode[46]
+ FineCode[45] FineCode[44] FineCode[43] FineCode[42] FineCode[41] FineCode[40] nFineCode[47] nFineCode[46] nFineCode[45] nFineCode[44]
+ nFineCode[43] nFineCode[42] nFineCode[41] nFineCode[40] CoarseOneHot[47] CoarseOneHot[46] CoarseOneHot[45] CoarseOneHot[44] CoarseOneHot[43]
+ CoarseOneHot[42] CoarseOneHot[41] CoarseOneHot[40] PadBias[5] PowerDown[5] BiasBranch
xBiasBranch6 VddA18 GndA BiasCB[7] BiasCB[6] BiasCB[5] BiasCB[4] BiasCB[3] BiasCB[2] BiasCB[1] BiasCB[0] BufferN BufferP Bias[6]
+ LowBiasInterfaceEn[6] nLowBiasInterfaceEn[6] FineCode[55] CoarseOneHotLowBiasEn[6] BIT0[6] NBiasEn[6] PBiasEn[6] BiasDisabled[6] FineCode[54]
+ FineCode[53] FineCode[52] FineCode[51] FineCode[50] FineCode[49] FineCode[48] nFineCode[55] nFineCode[54] nFineCode[53] nFineCode[52]
+ nFineCode[51] nFineCode[50] nFineCode[49] nFineCode[48] CoarseOneHot[55] CoarseOneHot[54] CoarseOneHot[53] CoarseOneHot[52] CoarseOneHot[51]
+ CoarseOneHot[50] CoarseOneHot[49] CoarseOneHot[48] PadBias[6] PowerDown[6] BiasBranch
xBiasBranch7 VddA18 GndA BiasCB[7] BiasCB[6] BiasCB[5] BiasCB[4] BiasCB[3] BiasCB[2] BiasCB[1] BiasCB[0] BufferN BufferP Bias[7]
+ LowBiasInterfaceEn[7] nLowBiasInterfaceEn[7] FineCode[63] CoarseOneHotLowBiasEn[7] BIT0[7] NBiasEn[7] PBiasEn[7] BiasDisabled[7] FineCode[62]
+ FineCode[61] FineCode[60] FineCode[59] FineCode[58] FineCode[57] FineCode[56] nFineCode[63] nFineCode[62] nFineCode[61] nFineCode[60]
+ nFineCode[59] nFineCode[58] nFineCode[57] nFineCode[56] CoarseOneHot[63] CoarseOneHot[62] CoarseOneHot[61] CoarseOneHot[60] CoarseOneHot[59]
+ CoarseOneHot[58] CoarseOneHot[57] CoarseOneHot[56] PadBias[7] PowerDown[7] BiasBranch
xBiasBranch8 VddA18 GndA BiasCB[7] BiasCB[6] BiasCB[5] BiasCB[4] BiasCB[3] BiasCB[2] BiasCB[1] BiasCB[0] BufferN BufferP Bias[8]
+ LowBiasInterfaceEn[8] nLowBiasInterfaceEn[8] FineCode[71] CoarseOneHotLowBiasEn[8] BIT0[8] NBiasEn[8] PBiasEn[8] BiasDisabled[8] FineCode[70]
+ FineCode[69] FineCode[68] FineCode[67] FineCode[66] FineCode[65] FineCode[64] nFineCode[71] nFineCode[70] nFineCode[69] nFineCode[68]
+ nFineCode[67] nFineCode[66] nFineCode[65] nFineCode[64] CoarseOneHot[71] CoarseOneHot[70] CoarseOneHot[69] CoarseOneHot[68] CoarseOneHot[67]
+ CoarseOneHot[66] CoarseOneHot[65] CoarseOneHot[64] PadBias[8] PowerDown[8] BiasBranch
xBiasBranch9 VddA18 GndA BiasCB[7] BiasCB[6] BiasCB[5] BiasCB[4] BiasCB[3] BiasCB[2] BiasCB[1] BiasCB[0] BufferN BufferP Bias[9]
+ LowBiasInterfaceEn[9] nLowBiasInterfaceEn[9] FineCode[79] CoarseOneHotLowBiasEn[9] BIT0[9] NBiasEn[9] PBiasEn[9] BiasDisabled[9] FineCode[78]
+ FineCode[77] FineCode[76] FineCode[75] FineCode[74] FineCode[73] FineCode[72] nFineCode[79] nFineCode[78] nFineCode[77] nFineCode[76]
+ nFineCode[75] nFineCode[74] nFineCode[73] nFineCode[72] CoarseOneHot[79] CoarseOneHot[78] CoarseOneHot[77] CoarseOneHot[76] CoarseOneHot[75]
+ CoarseOneHot[74] CoarseOneHot[73] CoarseOneHot[72] PadBias[9] PowerDown[9] BiasBranch
xBiasBranch10 VddA18 GndA BiasCB[7] BiasCB[6] BiasCB[5] BiasCB[4] BiasCB[3] BiasCB[2] BiasCB[1] BiasCB[0] BufferN BufferP Bias[10]
+ LowBiasInterfaceEn[10] nLowBiasInterfaceEn[10] FineCode[87] CoarseOneHotLowBiasEn[10] BIT0[10] NBiasEn[10] PBiasEn[10] BiasDisabled[10] FineCode[86]
+ FineCode[85] FineCode[84] FineCode[83] FineCode[82] FineCode[81] FineCode[80] nFineCode[87] nFineCode[86] nFineCode[85] nFineCode[84]
+ nFineCode[83] nFineCode[82] nFineCode[81] nFineCode[80] CoarseOneHot[87] CoarseOneHot[86] CoarseOneHot[85] CoarseOneHot[84] CoarseOneHot[83]
+ CoarseOneHot[82] CoarseOneHot[81] CoarseOneHot[80] PadBias[10] PowerDown[10] BiasBranch
.ends
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
