ckrajkumar/nic2025_openDVS/analog/klayout/production/final_merge_20260923/testbenches/cace/analog/openDVS_pixel2x2_rcc_calibre.spice

* PEX netlist: openDVS_pixel2x2 (mode=rcc, extracted by Calibre)
* Converted from Calibre RCC extraction to sky130/ngspice format
.subckt openDVS_pixel2x2 pixRst[1] pixRst[0] rowReadON[1] rowReadON[0] rowReadOFF[1] rowReadOFF[0] readLine[1] readLine[0] vpd[3] vpd[2] vpd[1] vpd[0] VddA18 GndA GndD OnBn OffBn DiffBn PrSFBp RefrBp PrBp

* SPICE netlist converted from spectre by scs2spice.py
* Source: openDVS_pixel2x2_rcc_.scs
* Generated for: spectre
* Generated on: May 22 15:09:28 2026
* Design library name: openDVS_pixel_4x4_klay_5_22_26
* Design cell name: openDVS_pixel2x2
* Design view name: calibre
* .lib "models.all.scs" tt  ** removed: Spectre model library

* Library name: openDVS_pixel_4x4_klay_5_22_26
* Cell name: openDVS_pixel2x2
* View name: calibre
vshort_vpd xPix[0].vpd xPix[0].DD1.pos 0
xPix[3].CC3 xPix[3].CC3.pos xPix[3].CC3.neg sky130_fd_pr__cap_mim_m3_1 w=2.27 l=3.985 m=1
xPix[3].CC1b xPix[3].CC1b.pos xPix[3].CC1b.neg sky130_fd_pr__cap_mim_m3_1 w=6.47 l=1.05 m=1
xPix[3].CC1 xPix[3].CC1.pos xPix[3].CC1.neg sky130_fd_pr__cap_mim_m3_1 w=1 l=1 m=1
xPix[1].CC3 xPix[1].CC3.pos xPix[1].CC3.neg sky130_fd_pr__cap_mim_m3_1 w=2.27 l=3.985 m=1
xPix[1].CC1b xPix[1].CC1b.pos xPix[1].CC1b.neg sky130_fd_pr__cap_mim_m3_1 w=6.47 l=1.05 m=1
xPix[1].CC1 xPix[1].CC1.pos xPix[1].CC1.neg sky130_fd_pr__cap_mim_m3_1 w=1 l=1 m=1
xPix[2].CC3 xPix[2].CC3.pos xPix[2].CC3.neg sky130_fd_pr__cap_mim_m3_1 w=2.27 l=3.985 m=1
xPix[2].CC1b xPix[2].CC1b.pos xPix[2].CC1b.neg sky130_fd_pr__cap_mim_m3_1 w=6.47 l=1.05 m=1
xPix[2].CC1 xPix[2].CC1.pos xPix[2].CC1.neg sky130_fd_pr__cap_mim_m3_1 w=1 l=1 m=1
xPix[0].CC3 xPix[0].CC3.pos xPix[0].CC3.neg sky130_fd_pr__cap_mim_m3_1 w=2.27 l=3.985 m=1
xPix[0].CC1b xPix[0].CC1b.pos xPix[0].CC1b.neg sky130_fd_pr__cap_mim_m3_1 w=6.47 l=1.05 m=1
xPix[0].CC1 xPix[0].CC1.pos xPix[0].CC1.neg sky130_fd_pr__cap_mim_m3_1 w=1 l=1 m=1
xPix[3].MMPDrefrCol xPix[3].MMPDrefrCol.d xPix[3].MMPDrefrCol.g xPix[3].net48 xPix[3].MMPDrefrCol.b
+ sky130_fd_pr__nfet_01v8 nf=1 w=0.42 l=0.15 m=1 as=0.1113 ad=0.1113 ps=0.95 pd=0.95 nrd=0.333333
+ nrs=0.333333 sa=0.265 sb=0.265 sd=0.28
xPix[3].MMPDRefrRow xPix[3].net48 xPix[3].MMPDRefrRow.g xPix[3].MMPDRefrRow.s xPix[3].MMPDRefrRow.b
+ sky130_fd_pr__nfet_01v8 nf=1 w=0.42 l=0.15 m=1 as=0.1113 ad=0.1113 ps=0.95 pd=0.95 nrd=0.333333
+ nrs=0.333333 sa=0.265 sb=0.265 sd=0.28
xPix[3].MMN8 xPix[3].net47 xPix[3].MMN8.g xPix[3].MMN8.s xPix[3].MMN8.b sky130_fd_pr__nfet_01v8 nf=1 w=0.42 l=0.15 m=1
+ as=0.1113 ad=0.1113 ps=0.95 pd=0.95 nrd=0.333333 nrs=0.333333 sa=0.265
+ sb=0.265 sd=0.28
xPix[3].MMN7 xPix[3].net46 xPix[3].MMN7.g xPix[3].MMN7.s xPix[3].MMN7.b sky130_fd_pr__nfet_01v8 nf=1 w=0.42 l=0.15 m=1
+ as=0.1113 ad=0.1113 ps=0.95 pd=0.95 nrd=0.333333 nrs=0.333333 sa=0.265
+ sb=0.265 sd=0.28
xPix[3].MMN11 xPix[3].MMN11.d xPix[3].MMN11.g xPix[3].net47 xPix[3].MMN11.b sky130_fd_pr__nfet_01v8 nf=1 w=0.42 l=0.15
+ m=1 as=0.1113 ad=0.1113 ps=0.95 pd=0.95 nrd=0.333333 nrs=0.333333 sa=0.265
+ sb=0.265 sd=0.28
xPix[3].MMN10 xPix[3].MMN10.d xPix[3].MMN10.g xPix[3].net46 xPix[3].MMN10.b sky130_fd_pr__nfet_01v8 nf=1 w=0.42 l=0.15
+ m=1 as=0.1113 ad=0.1113 ps=0.95 pd=0.95 nrd=0.333333 nrs=0.333333 sa=0.265
+ sb=0.265 sd=0.28
xPix[1].MMPDrefrCol xPix[1].MMPDrefrCol.d xPix[1].MMPDrefrCol.g xPix[1].net48 xPix[1].MMPDrefrCol.b
+ sky130_fd_pr__nfet_01v8 nf=1 w=0.42 l=0.15 m=1 as=0.1113 ad=0.1113 ps=0.95 pd=0.95 nrd=0.333333
+ nrs=0.333333 sa=0.265 sb=0.265 sd=0.28
xPix[1].MMPDRefrRow xPix[1].net48 xPix[1].MMPDRefrRow.g xPix[1].MMPDRefrRow.s xPix[1].MMPDRefrRow.b
+ sky130_fd_pr__nfet_01v8 nf=1 w=0.42 l=0.15 m=1 as=0.1113 ad=0.1113 ps=0.95 pd=0.95 nrd=0.333333
+ nrs=0.333333 sa=0.265 sb=0.265 sd=0.28
xPix[1].MMN8 xPix[1].net47 xPix[1].MMN8.g xPix[1].MMN8.s xPix[1].MMN8.b sky130_fd_pr__nfet_01v8 nf=1 w=0.42 l=0.15 m=1
+ as=0.1113 ad=0.1113 ps=0.95 pd=0.95 nrd=0.333333 nrs=0.333333 sa=0.265
+ sb=0.265 sd=0.28
xPix[1].MMN7 xPix[1].net46 xPix[1].MMN7.g xPix[1].MMN7.s xPix[1].MMN7.b sky130_fd_pr__nfet_01v8 nf=1 w=0.42 l=0.15 m=1
+ as=0.1113 ad=0.1113 ps=0.95 pd=0.95 nrd=0.333333 nrs=0.333333 sa=0.265
+ sb=0.265 sd=0.28
xPix[1].MMN11 xPix[1].MMN11.d xPix[1].MMN11.g xPix[1].net47 xPix[1].MMN11.b sky130_fd_pr__nfet_01v8 nf=1 w=0.42 l=0.15
+ m=1 as=0.1113 ad=0.1113 ps=0.95 pd=0.95 nrd=0.333333 nrs=0.333333 sa=0.265
+ sb=0.265 sd=0.28
xPix[1].MMN10 xPix[1].MMN10.d xPix[1].MMN10.g xPix[1].net46 xPix[1].MMN10.b sky130_fd_pr__nfet_01v8 nf=1 w=0.42 l=0.15
+ m=1 as=0.1113 ad=0.1113 ps=0.95 pd=0.95 nrd=0.333333 nrs=0.333333 sa=0.265
+ sb=0.265 sd=0.28
xPix[2].MMPDrefrCol xPix[2].MMPDrefrCol.d xPix[2].MMPDrefrCol.g xPix[2].net48 xPix[2].MMPDrefrCol.b
+ sky130_fd_pr__nfet_01v8 nf=1 w=0.42 l=0.15 m=1 as=0.1113 ad=0.1113 ps=0.95 pd=0.95 nrd=0.333333
+ nrs=0.333333 sa=0.265 sb=0.265 sd=0.28
xPix[2].MMPDRefrRow xPix[2].net48 xPix[2].MMPDRefrRow.g xPix[2].MMPDRefrRow.s xPix[2].MMPDRefrRow.b
+ sky130_fd_pr__nfet_01v8 nf=1 w=0.42 l=0.15 m=1 as=0.1113 ad=0.1113 ps=0.95 pd=0.95 nrd=0.333333
+ nrs=0.333333 sa=0.265 sb=0.265 sd=0.28
xPix[2].MMN8 xPix[2].net47 xPix[2].MMN8.g xPix[2].MMN8.s xPix[2].MMN8.b sky130_fd_pr__nfet_01v8 nf=1 w=0.42 l=0.15 m=1
+ as=0.1113 ad=0.1113 ps=0.95 pd=0.95 nrd=0.333333 nrs=0.333333 sa=0.265
+ sb=0.265 sd=0.28
xPix[2].MMN7 xPix[2].net46 xPix[2].MMN7.g xPix[2].MMN7.s xPix[2].MMN7.b sky130_fd_pr__nfet_01v8 nf=1 w=0.42 l=0.15 m=1
+ as=0.1113 ad=0.1113 ps=0.95 pd=0.95 nrd=0.333333 nrs=0.333333 sa=0.265
+ sb=0.265 sd=0.28
xPix[2].MMN11 xPix[2].MMN11.d xPix[2].MMN11.g xPix[2].net47 xPix[2].MMN11.b sky130_fd_pr__nfet_01v8 nf=1 w=0.42 l=0.15
+ m=1 as=0.1113 ad=0.1113 ps=0.95 pd=0.95 nrd=0.333333 nrs=0.333333 sa=0.265
+ sb=0.265 sd=0.28
xPix[2].MMN10 xPix[2].MMN10.d xPix[2].MMN10.g xPix[2].net46 xPix[2].MMN10.b sky130_fd_pr__nfet_01v8 nf=1 w=0.42 l=0.15
+ m=1 as=0.1113 ad=0.1113 ps=0.95 pd=0.95 nrd=0.333333 nrs=0.333333 sa=0.265
+ sb=0.265 sd=0.28
xPix[0].MMPDrefrCol xPix[0].MMPDrefrCol.d xPix[0].MMPDrefrCol.g xPix[0].net48 xPix[0].MMPDrefrCol.b
+ sky130_fd_pr__nfet_01v8 nf=1 w=0.42 l=0.15 m=1 as=0.1113 ad=0.1113 ps=0.95 pd=0.95 nrd=0.333333
+ nrs=0.333333 sa=0.265 sb=0.265 sd=0.28
xPix[0].MMPDRefrRow xPix[0].net48 xPix[0].MMPDRefrRow.g xPix[0].MMPDRefrRow.s xPix[0].MMPDRefrRow.b
+ sky130_fd_pr__nfet_01v8 nf=1 w=0.42 l=0.15 m=1 as=0.1113 ad=0.1113 ps=0.95 pd=0.95 nrd=0.333333
+ nrs=0.333333 sa=0.265 sb=0.265 sd=0.28
xPix[0].MMN8 xPix[0].net47 xPix[0].MMN8.g xPix[0].MMN8.s xPix[0].MMN8.b sky130_fd_pr__nfet_01v8 nf=1 w=0.42 l=0.15 m=1
+ as=0.1113 ad=0.1113 ps=0.95 pd=0.95 nrd=0.333333 nrs=0.333333 sa=0.265
+ sb=0.265 sd=0.28
xPix[0].MMN7 xPix[0].net46 xPix[0].MMN7.g xPix[0].MMN7.s xPix[0].MMN7.b sky130_fd_pr__nfet_01v8 nf=1 w=0.42 l=0.15 m=1
+ as=0.1113 ad=0.1113 ps=0.95 pd=0.95 nrd=0.333333 nrs=0.333333 sa=0.265
+ sb=0.265 sd=0.28
xPix[0].MMN11 xPix[0].MMN11.d xPix[0].MMN11.g xPix[0].net47 xPix[0].MMN11.b sky130_fd_pr__nfet_01v8 nf=1 w=0.42 l=0.15
+ m=1 as=0.1113 ad=0.1113 ps=0.95 pd=0.95 nrd=0.333333 nrs=0.333333 sa=0.265
+ sb=0.265 sd=0.28
xPix[0].MMN10 xPix[0].MMN10.d xPix[0].MMN10.g xPix[0].net46 xPix[0].MMN10.b sky130_fd_pr__nfet_01v8 nf=1 w=0.42 l=0.15
+ m=1 as=0.1113 ad=0.1113 ps=0.95 pd=0.95 nrd=0.333333 nrs=0.333333 sa=0.265
+ sb=0.265 sd=0.28
xPix[3].MMP0 xPix[3].MMP0.d xPix[3].MMP0.g xPix[3].MMP0.s xPix[3].MMP0.b sky130_fd_pr__pfet_01v8_hvt nf=1 w=0.42 l=1.5
+ m=1 as=0.126 ad=0.126 ps=1.02 pd=1.02 nrd=0 nrs=0 sa=0.265 sb=0.265 sd=0.28
xPix[1].MMP0 xPix[1].MMP0.d xPix[1].MMP0.g xPix[1].MMP0.s xPix[1].MMP0.b sky130_fd_pr__pfet_01v8_hvt nf=1 w=0.42 l=1.5
+ m=1 as=0.126 ad=0.126 ps=1.02 pd=1.02 nrd=0 nrs=0 sa=0.265 sb=0.265 sd=0.28
xPix[2].MMP0 xPix[2].MMP0.d xPix[2].MMP0.g xPix[2].MMP0.s xPix[2].MMP0.b sky130_fd_pr__pfet_01v8_hvt nf=1 w=0.42 l=1.5
+ m=1 as=0.126 ad=0.126 ps=1.02 pd=1.02 nrd=0 nrs=0 sa=0.265 sb=0.265 sd=0.28
xPix[0].MMP0 xPix[0].MMP0.d xPix[0].MMP0.g xPix[0].MMP0.s xPix[0].MMP0.b sky130_fd_pr__pfet_01v8_hvt nf=1 w=0.42 l=1.5
+ m=1 as=0.126 ad=0.126 ps=1.02 pd=1.02 nrd=0 nrs=0 sa=0.265 sb=0.265 sd=0.28
* DD1 parasitic diodes replaced with 1T-ohm resistors (diode model causes transient convergence failure)
rDD1_2 xPix[2].DD1.pos xPix[2].DD1.neg 1e12
rDD1_3 xPix[3].DD1.pos xPix[3].DD1.neg 1e12
rDD1_0 xPix[0].DD1.pos xPix[0].DD1.neg 1e12
rDD1_1 xPix[1].DD1.pos xPix[1].DD1.neg 1e12
* CC3.pos (vd node) DC stabilizers: floating in DC when reset switch is OFF
rCC3stab_0 xPix[0].CC3.pos GndA 1e12
rCC3stab_1 xPix[1].CC3.pos GndA 1e12
rCC3stab_2 xPix[2].CC3.pos GndA 1e12
rCC3stab_3 xPix[3].CC3.pos GndA 1e12
xPix[3].MMon xPix[3].MMon.d xPix[3].MMon.g xPix[3].MMon.s xPix[3].MMon.b sky130_fd_pr__pfet_01v8 nf=1 w=1.5 l=1.5 m=1
+ as=0.45 ad=0.45 ps=2.1 pd=2.1 nrd=0 nrs=0 sa=0.265 sb=0.265 sd=0.28
xPix[3].MMchAmp xPix[3].MMchAmp.d xPix[3].MMchAmp.g xPix[3].MMchAmp.s xPix[3].MMchAmp.b sky130_fd_pr__pfet_01v8 nf=1
+ w=1.5 l=1.5 m=1 as=0.45 ad=0.45 ps=2.1 pd=2.1 nrd=0 nrs=0 sa=0.265 sb=0.265
+ sd=0.28
xPix[3].MMcapRef xPix[3].MMcapRef.d xPix[3].MMcapRef.g xPix[3].MMcapRef.s xPix[3].MMcapRef.b sky130_fd_pr__pfet_01v8
+ nf=1 w=1.5 l=1.5 m=1 as=0.45 ad=0.45 ps=2.1 pd=2.1 nrd=0 nrs=0 sa=0.265
+ sb=0.265 sd=0.28
xPix[3].MMP2 xPix[3].MMP2.d xPix[3].MMP2.g xPix[3].MMP2.s xPix[3].MMP2.b sky130_fd_pr__pfet_01v8 nf=1 w=1.5 l=1.5 m=1
+ as=0.45 ad=0.45 ps=2.1 pd=2.1 nrd=0 nrs=0 sa=0.265 sb=0.265 sd=0.28
xPix[1].MMon xPix[1].MMon.d xPix[1].MMon.g xPix[1].MMon.s xPix[1].MMon.b sky130_fd_pr__pfet_01v8 nf=1 w=1.5 l=1.5 m=1
+ as=0.45 ad=0.45 ps=2.1 pd=2.1 nrd=0 nrs=0 sa=0.265 sb=0.265 sd=0.28
xPix[1].MMchAmp xPix[1].MMchAmp.d xPix[1].MMchAmp.g xPix[1].MMchAmp.s xPix[1].MMchAmp.b sky130_fd_pr__pfet_01v8 nf=1
+ w=1.5 l=1.5 m=1 as=0.45 ad=0.45 ps=2.1 pd=2.1 nrd=0 nrs=0 sa=0.265 sb=0.265
+ sd=0.28
xPix[1].MMcapRef xPix[1].MMcapRef.d xPix[1].MMcapRef.g xPix[1].MMcapRef.s xPix[1].MMcapRef.b sky130_fd_pr__pfet_01v8
+ nf=1 w=1.5 l=1.5 m=1 as=0.45 ad=0.45 ps=2.1 pd=2.1 nrd=0 nrs=0 sa=0.265
+ sb=0.265 sd=0.28
xPix[1].MMP2 xPix[1].MMP2.d xPix[1].MMP2.g xPix[1].MMP2.s xPix[1].MMP2.b sky130_fd_pr__pfet_01v8 nf=1 w=1.5 l=1.5 m=1
+ as=0.45 ad=0.45 ps=2.1 pd=2.1 nrd=0 nrs=0 sa=0.265 sb=0.265 sd=0.28
xPix[2].MMon xPix[2].MMon.d xPix[2].MMon.g xPix[2].MMon.s xPix[2].MMon.b sky130_fd_pr__pfet_01v8 nf=1 w=1.5 l=1.5 m=1
+ as=0.45 ad=0.45 ps=2.1 pd=2.1 nrd=0 nrs=0 sa=0.265 sb=0.265 sd=0.28
xPix[2].MMchAmp xPix[2].MMchAmp.d xPix[2].MMchAmp.g xPix[2].MMchAmp.s xPix[2].MMchAmp.b sky130_fd_pr__pfet_01v8 nf=1
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
cireadLine[1]_22 readLine[1]_11 GndA 1.35234e-16
cireadLine[1]_21 readLine[1]_14 GndA 1.6023e-17
cireadLine[1]_20 readLine[1]_15 GndA 1.88161e-16
cireadLine[1]_19 readLine[1]_16 GndA 7.16414e-17
cireadLine[1]_18 readLine[1]_18 GndA 5.04859e-17
cireadLine[1]_17 readLine[1]_20 GndA 1.11661e-17
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
