ckrajkumar/nic2025_openDVS/analog/klayout/production/final_merge_20260923/testbenches/cace/analog/cace/PixelComparators.yaml

#--------------------------------------------------------------
# CACE circuit characterization file
#--------------------------------------------------------------

name:           PixelComparators
description:    Pixel comparators DC threshold characterization
PDK:            sky130B

cace_format:    5.2

authorship:
  designer:         Rui Graca
  creation_date:    21 Apr, 2026

paths:
  root:             ..
  schematic:        xschem
  netlist:          netlist

pins:
  vdd:
    description: Positive power supply
    type: power
    direction: inout
    Vmin: 1.62
    Vmax: 1.98
  OnBn:
    description: ON comparator bias
    type: signal
    direction: input
  OffBn:
    description: OFF comparator bias
    type: signal
    direction: input
  gnd:
    description: Ground
    type: ground
    direction: inout
  vdiff:
    description: Differential input
    type: signal
    direction: input
  ON:
    description: ON comparator output
    type: signal
    direction: output
  nOFF:
    description: OFF comparator output (active low)
    type: signal
    direction: output

default_conditions:
  vdd:
    description: Power supply voltage
    display: Vdd
    unit: V
    minimum: 1.62
    typical: 1.8
    maximum: 1.98
  corner:
    description: Process corner
    display: Corner
    typical: tt
  temperature:
    description: Ambient temperature
    display: Temp
    unit: "\u00b0C"
    minimum: 0
    typical: 27
    maximum: 50
  xBiasSet:
    description: "Bias set: 1=OnBn200n/OffBn0.5n, 2=OnBn100n/OffBn1n"
    display: BiasSet
    typical: 1

parameters:
  comparator_dc:
    display: Comparator DC threshold characterization
    spec:
      vthresh_on:
        display: ON Threshold
        description: Vdiff at which ON output crosses vdd/2 (rising)
        unit: V
        minimum:
          value: any
        typical:
          value: any
        maximum:
          value: any
      vthresh_off:
        display: OFF Threshold
        description: Vdiff at which nOFF output crosses vdd/2 (falling)
        unit: V
        minimum:
          value: any
        typical:
          value: any
        maximum:
          value: any
      on_thresh_input:
        display: ON Input Threshold
        description: ON threshold referred to photoreceptor input (photodiode current change)
        unit: ""
        minimum:
          value: any
        typical:
          value: any
        maximum:
          value: any
      off_thresh_input:
        display: OFF Input Threshold
        description: OFF threshold referred to photoreceptor input (photodiode current change)
        unit: ""
        minimum:
          value: any
        typical:
          value: any
        maximum:
          value: any
    tool:
      ngspice:
        template: tb_PixelComparators_dc.sch
        format: ascii
        suffix: .data
        variables: [vthresh_on, vthresh_off, on_thresh_input, off_thresh_input]
    conditions:
      vdd:
        enumerate: [1.62, 1.8, 1.98]
      temperature:
        enumerate: [0, 27, 50, 70]
      corner:
        enumerate: [tt, ss, ff, sf, fs]
      xBiasSet:
        enumerate: [1, 2]

  comparator_dc_mc:
    display: Comparator DC threshold Monte Carlo
    spec:
      vthresh_on:
        display: ON Threshold
        description: Vdiff at which ON output crosses vdd/2 (falling) (MC)
        unit: V
        minimum:
          value: any
        typical:
          value: any
        maximum:
          value: any
      vthresh_off:
        display: OFF Threshold
        description: Vdiff at which nOFF output crosses vdd/2 (falling) (MC)
        unit: V
        minimum:
          value: any
        typical:
          value: any
        maximum:
          value: any
      on_thresh_input:
        display: ON Input Threshold
        description: ON threshold referred to photoreceptor input (MC)
        unit: ""
        minimum:
          value: any
        typical:
          value: any
        maximum:
          value: any
      off_thresh_input:
        display: OFF Input Threshold
        description: OFF threshold referred to photoreceptor input (MC)
        unit: ""
        minimum:
          value: any
        typical:
          value: any
        maximum:
          value: any
    tool:
      ngspice:
        template: tb_PixelComparators_dc_mc.sch
        collate: iterations
        format: ascii
        suffix: .data
        variables: [vthresh_on, vthresh_off, on_thresh_input, off_thresh_input]
    conditions:
      vdd:
        typical: 1.8
      temperature:
        typical: 27
      corner:
        typical: tt_mm
      xBiasSet:
        typical: 2
      iterations:
        description: Monte Carlo iteration
        display: Iteration
        minimum: 0
        maximum: 499
        step: linear
        stepsize: 1
