ckrajkumar/nic2025_openDVS/(commit log)

2025-08-21 added and simulated biasgen, working but needs optimization
    [BiasMasterBias.sch, test_BiasMasterBias.sch]
2025-09-02 added idle level switch to column amplifier
    [1x1array_tb.sch, col_amp.sch]
2025-09-03 created subblock for sense amp in col amp
    [col_amp.sch, sense_amp.sch]
2025-09-03 added current probe to ipd
    [1x1array_tb.sch]
2025-09-23 added pixel comparison tb
    [openDVS_pixel_tia.sch, pixel_comparison_tb.sch]
2025-09-24 fixed off grid voltage sources
    [pixel_comparison_tb.sch]
2025-10-02 added bias master circuits and tb
    [BiasCoarseMBDivider.sch, BiasDivider.sch, BiasDividerCell.sch, BiasMasterBias.sch, BiasMasternCoarse.sch, BiasMultiplier.sch, BiasMultiplierCell.sch, tb_BiasMasternCoarse.sch]
2025-10-03 added BiasCoarseBuffer and subcircuits. not yet simulated, but it netlists
    [BiasCoarseBuffer.sch, BiasCoarseSel8to1.sch, BiasDec3to8.sch, BiasDecCB0.sch, BiasDecCB1.sch, BiasLatch.sch, Bias_Inv_Decoder.sch]
2025-10-03 fixed power pin names in stdcell
    [BiasCoarseBuffer.sch]
2025-10-03 added BiasCoarseFineInterface schematic
    [BiasCoarseFineInterface.sch]
2025-10-06 added all cells of BiasBranchnMaster hierarchy. not yet simulated
    [BiasBranch.sch, BiasBranchBuffer.sch, BiasBranchnMaster.sch, BiasBuffers.sch, BiasCoarseFineInterface.sch, BiasDividerFine.sch, BiasDividerFineCell.sch]
2025-10-20 simulating biasgen
    [BiasDec3to8.sch, BiasMasterBias.sch, tb_BiasCoarseBuffer.sch, tb_BiasDivider.sch, tb_BiasMasterBias.sch, tb_BiasMasternCoarse.sch, tb_BiasMultiplier.sch, test_BiasMasterBias.sch]
2025-10-21 added local copies of stdcells
    [BiasCoarseBuffer.sch, BiasCoarseFineInterface.sch, BiasCoarseSel8to1.sch, sky130_fd_sc_hd__inv_1.sch, sky130_fd_sc_hd__nor2_1.sch, sky130_fd_sc_hd__or4_1.sch]
2025-10-21 added cace files for BiasCoarseBuffer op sim
    [tb_BiasCoarseBuffer.sch]
2025-10-23 sample serial encoding
2025-10-23 spice files for ota clamp and col_amp
2025-10-28 fixed op of bias coarse. now working in typical
    [BiasCoarseFineInterface.sch, BiasCoarseMBDivider.sch, BiasCoarseSel8to1.sch, BiasMasterBias.sch, tb_BiasMasterBias.sch]
2025-10-28 working on BiasBuffers, still need to improve OP for low biases
    [BiasBranch.sch, BiasBuffers.sch, tb_BiasBuffers.sch]
2025-10-29 Adding dynamic comparator
    [dyn_comp.sch]
2025-10-29 dynamic comparator test for refference
    [test_comp.sch]
2025-10-29 updated BiasBuffers and added testbenches
    [BiasBranch.sch, BiasBranchBuffer.sch, BiasBranchnMaster.sch, BiasBuffers.sch, BiasCoarseFineInterface.sch, BiasCoarseMBDivider.sch, BiasDividerFineCell.sch, BiasLatch.sch]
2025-10-30 fixed bugs on BiasDividerFine and changed it to lvt, but some other OP issues came up
    [BiasBranchnMasterx1.sch, BiasCoarseFineInterface.sch, BiasDividerFine.sch, BiasDividerFineCell.sch, BiasLatch.sch, sky130_fd_sc_hd__and2_1.sch]
2025-11-04 change in col_amp
    [amp_p_5T.sch, clamp_qdvs_v2.sch, col_amp_v1.sch, openDVS_pixel_tia_RL_v1.sch, tran_col_notopota_clmp_pix.sch, tran_col_pix.sch]
2025-11-04 I accidenctly pushed a modified test_comp
    [test_comp.sch]
2025-11-07 moved openDVS_pixel_tia to openDVS_pixel
    [openDVS_pixel.sch, openDVS_pixel_tia.sch]
2025-11-07 update tran_col_pix and col_amp_v1
    [col_amp_v1.sch, tran_col_pix.sch]
2025-11-13 update clamp and column_layout_schem
    [analog_column_layout_schem.sch, clamp_qdvs_v2.sch, column_layout_schem.sch]
2025-11-13 Add testbench for column amplifier and ota
    [Col_Amp_notop_ota_TB.sch, test_ota.sch]
2025-11-19 adding a 3rd version of the dynamic comp for more accurate pin matching
    [dyn_comp_v3.sch]
2026-02-26 changing pixel from qdvs to standard dvs
    [openDVS_pixel.sch, pixel_tb.sch]
2026-04-02 new column amplifier schematics and testbenches
    [TRAN_TB.sch, TRAN_TB_ASYNC.sch, TRAN_TB_COL.sch, TRAN_TF_TB.sch, TRAN_TR_TB.sch, col_amp.sch, col_amp_gds.sch, column_gds.sch]
2026-04-06 testbench connecting pixel charge amp->pixel comparators->column amp->column comparator->registers to latch data
    [BiasCoarseMBDivider_NoBiasMult_NoBiasDivider.sch, BiasCoarseMB_DIV_W005_L200_8.sch, BiasCoarseMB_DIV_W010_L100_8.sch, BiasCoarseMB_DIV_W019_L050_8.sch, TRAN_TB.sch, TRAN_TB_ASYNC.sch, TRAN_TB_COL.sch, TRAN_TB_COL_v2_pixRst.sch]
2026-04-10 removed digital blocks from biasgen
    [BiasBranch.sch, BiasBranchBuffer.sch, BiasBranchnMasterx1.sch, BiasBuffers.sch, BiasCoarseFineInterface.sch, BiasCoarseSel8to1.sch, BiasDividerFine.sch, tb_BiasBranchnMasterx1_op.sch]
2026-04-16 biasbuffer and biasdividerfine gds
    BiasBuffer and BiasDividerFine as well as the S130 layermap for V2.1.306 just in case
2026-04-16 fixed bug in master bias bootstrap and added testbenches
    [BiasMasterBias.sch, tb_BiasMasterBias_bootstrap.sch]
2026-04-21 updated pixel and pixel sims
    [PixelChangeAmplifier.sch, PixelComparators.sch, PixelGainAC.sch, PixelHandshake.sch, PixelPhotoreceptor.sch, PixelResetGen.sch, PixelSourceFollower.sch, openDVS_pixel.sch]
2026-04-22 dyn_comp_v2 cadence gds and schematic
2026-04-27 working on pixel layout
    [PixelChangeAmplifier.sch, PixelComparators.sch, PixelHandshake.sch, PixelPhotoreceptor.sch, PixelResetGen.sch, PixelSourceFollower.sch]
2026-04-27 updated pixel
    [PixelPhotoreceptor.sch, PixelResetGen.sch, PixelSourceFollower.sch]
2026-05-05 spice file and minor changes
    [BiasBuffers.sch]
2026-05-06 pixel 2x2 lvs pass
    [PixelChangeAmplifier.sch, PixelResetGen.sch, openDVS_pixel.sch]
2026-05-06 updated biasgen schematics and fixed bugs in tb
    [BiasBranch.sch, BiasBranchnMasterx1.sch, tb_BiasBranchnMasterx1_op.sch]
2026-05-06 added bias branch master x11
    [BiasBranchnMasterx11.sch]
2026-05-08 updated pixel. lvs pass drc clean with photodiode
    [PixelChangeAmplifier.sch, PixelPhotoreceptor.sch]
2026-05-12 bias gen file change
    [BiasBranch.sch, BiasBranchnMasterx1.sch, BiasBuffers.sch]
2026-05-12 bias gen changes
    [BiasBranch.sch, BiasBranchnMasterx1.sch, BiasBuffers.sch, tb_BiasBranchnMasterx1_op.sch]
2026-05-12 removed unneccary biasgen files
    [tb_BiasBranchnMasterx1_op.sch]
2026-05-12 new verilog files
    [BiasBuffers.sch, tb_BiasBranchnMasterx1_op.sch]
2026-05-14 final gds before check
    [BiasBranchnMasterx11.sch]
2026-05-15 pixel 4 tile v8 new vdd gnd pdn
2026-05-18 updated BiasBranchnMasterx11 and pixeltile_schem
    [BiasCoarseFineInterface.sch, BiasCoarseFineInterface_with_MpDum1.sch, BiasDivider.sch, BiasDivider_correct_no_cap.sch, col_amp_2x1.sch, dyn_comp.sch, openDVS_pixel2x2.sch, pixel_4tile.sch]
2026-05-19 split ChAmp coupling cap, add 2x2 PEX CACE characterizations
    - PixelChangeAmplifier: split C1 into C1a+C1b for layout, add vsf-vd wiring
    - Add 2x2 array CACE YAMLs, templates, and scripts for GainAC, ResetTran,
    Comparators, Photoreceptor, and AutoReadLine characterizations
    - Update existing CACE templates for PEX extraction type selection
    - Add MC testbench templates and scripts
    [PixelChangeAmplifier.sch, tb_PixelAutoReadLine_tran_2x2.sch, tb_PixelComparators_dc_2x2.sch, tb_PixelComparators_dc_mc.sch, tb_PixelGain_ac_2x2.sch, tb_PixelGain_ac_mc.sch, tb_PixelPhotoreceptor_dc_2x2.sch, tb_PixelResetTran_2x2.sch]
2026-05-20 updated pixel layout
    [PixelSourceFollower.sch, openDVS_pixel2x2.sch]
2026-05-20 updated pixel tb and added scripts
    [tb_PixelComparators_dc_2x2.sch, tb_PixelComparators_thresh_dc.sch, tb_PixelGain_ac_2x2.sch, tb_PixelPhotoreceptor_dc_2x2.sch, tb_PixelReset_tran.sch, tb_PixelReset_tran_2x2.sch, tb_Pixel_autoreadLine_tran_2x2.sch]
2026-05-20 removed runs/ from git
    [simulation_summary.csv, tb_BiasBranchnMasterx1_op.sch, tb_PixelPhotoreceptor_dc.sch]
2026-07-09 fix run_drc.sh: flatten KLayout PCell subcells so magic reads taps correctly
    Magic resolves GDS layers per-cell, so KLayout PCell contact/tap subcells
    (tap+licon without the parent's implant/nwell layers) were misread as
    pdiff/pwell, causing false diff/tap.8, nwell.4 and LU.* violations.
    Flatten contact/nfet/pfet cells on gds read.
    Also fix the report generation (drc listall count/why pair parsing was
    wrong, leaving the detailed section empty), print violation boxes in um,
    and exit nonzero when errors are found.
2026-07-09 add KLayout magic-DRC macro to repo with install script
    magic_drc.lym (Tools > DRC > Run Magic DRC, Shift+D) runs magic DRC on
    the current layout and shows violations in the marker browser. It embeds
    the same gds flatglob fix as run_drc.sh for KLayout PCell subcells.
    install_klayout_macros.sh symlinks it into ~/.klayout/pymacros so git
    updates propagate without reinstalling.
2026-07-09 magic_drc.lym: replace blocking pre-run dialog with self-closing busy dialog
    The modal QMessageBox shown before running magic blocked until the user
    pressed OK, looking like a stuck "waiting" window (magic only started
    after dismissing it). Now a cancel-button-less QProgressDialog shows
    while magic runs via Popen with the Qt event loop pumped, and closes
    itself when magic exits.
2026-07-10 pixel 4 tile and bias gen
    [BiasBranchnMasterx11.sch, BiasBranchnMasterx11_layout.sch, BiasBranchnMasterx11_og.sch, BiasBranchnMasterx11_renamed.sch, BiasBuffers.sch, BiasCoarseFineInterface.sch, BiasCoarseSel8to1.sch, BiasMasternCoarse.sch]
2026-08-12 gds file with fewer outputs so to match with the pad frame
2026-08-12 recent changes
    [BiasBranchnMasterx11.sch, infiniamp_xl.sch, infiniamp_xl_layout.sch, tb_infiniamp_x1.sch]
2026-08-24 phase5-pixel: align C1b schematic with intended layout
    [PixelChangeAmplifier.sch]
2026-09-12 new test structure gds for easier power routing
2026-09-13 new schematic netlists for analog blocks
2026-09-13 new test structures with proper vdd and gnd names
2026-09-18 BiasBranchnMasterx11 gds that pass lvtn and nwell drc enclosure
2026-09-22 klayout/production: openDVS pixel layout edit20260922l — reset-release ON event removed by layout only
    pixel_4tile_work.gds (= pixel_4tile_work.edit20260922l.gds, sha256 71c72c6c…) is the working layout after
    the 2026-09-21/22 rounds: Mrst L-finger gate contact, GndA/VddA18 shields around the nRst column and under
    the vsf MIM plate, nRst run/leg moves (C(nRst,vd) 0.654 -> 0.073 fF, C(nRst,vsf) 0.458 -> 0.114 fF, Quantus),
    and a GndA met3 strip between the pixRst met3 column and the vsf MIM plate (C(pixRst,vsf) 0.202 -> 0.000 fF),
    which removes the slow post-reset vdiff slide. Devices and MIM caps unchanged; LVS MATCH on the 2x2 (flat
    63 nets); 4x4 Magic DRC = 840 abut + capm.11 (32 -> 48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
2026-09-22 klayout/production: edit20260922m — legal pixRst shield (capm.11 clean), replaces l
    l (a11af38e) put a GndA met3 strip 0.66-0.75 um from the MIM plates, violating capm.11 (1.34 um to unrelated met3,
    Magic: 32 -> 480 boxes on the 4x4). m = k + z1 removed + vsf met3 arm narrowed to 2.90-3.31 + GndA met2 strip
    1.82-2.19 x 3.45-7.48 (tied to the existing GndA met2 piece at 2.335-2.72 x 3.40-3.955) + GndA met3 strip
    1.57-2.60 x 4.50-7.76 with a via2 to it. Quantus pixel 0: C(pixRst,vsf) 0.202 -> 0.124 fF, C(pixRst,vd)
    0.150 -> 0.109, nRst couplings unchanged (0.071 / 0.114). LVS MATCH (flat 63 nets); 4x4 Magic DRC = 840 abut +
    32 capm.11 = the pristine baseline. TB at IRefrBp 4 nA nominal: vdif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
2026-09-22 openDVS pixel edit20260922n: pixRst/readLine columns on met4, row lines moved off the MIM plates, C1a/C2 shifted north (rounds 10-11j)
    Layout-only, LVS unchanged (KLayout flat MATCH 61/80, PVS LVS MATCH), 4x4 Magic DRC = baseline (840 abut + 32 capm.11; bot + the pre-existing met1.1 x4),
    PDK KLayout BEOL DRC 0 items. Every toggling global line (pixRst, readLine, rowReadON, rowReadOFF) decoupled from vsf/vd/vdiff:
    - pixRst and readLine met3 columns cut to three short stubs each (0.13-0.86 / 1.50-2.23 / 10.54-11.27) and carried on met4 (0.94-1.27 / 0.31-0.64)
    through the pixel with via3 on the stubs; VddA18 met4 plane slotted |x|<1.67; vd met4 ring west arm 1.855->2.33; VddA18 met4 shield s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
2026-09-22 openDVS pixel edit20260922p: rounds 10-13 — pixRst/readLine columns on met4, C1a +0.8 / C2 +0.33 north, production row-line topology kept
    Layout-only, LVS unchanged. KLayout flat LVS MATCH 61/80; PDK KLayout deck (FEOL+BEOL) 0 items on the 2x2 and on the 4x4; Magic 4x4 DRC = baseline
    (840 abut + 32 capm.11, bot + the pre-existing met1.1 x4). Supersedes edit20260922n/o (their per-row GndD line shorted the neighbouring tile's row lines
    in an array and made the 2x2 a 22-port macro).
    - pixRst and readLine: met3 columns cut to three short stubs (0.13-0.86 / 1.50-2.23 / 10.54-11.27) so the 2x2 bridge cells still meet met3, carried on met4
    (0.94-1.27 / 0.31-0.64) through the pixel with via3 on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
2026-09-22 openDVS pixel edit20260922r14d: round 14 — C1a back at the production position, row lines into the pair-mirror band, GndD per row joined in-pixel
    Layout-only, LVS unchanged. KLayout flat LVS MATCH 61/80 (flat 2x2: 63 nets, GndD one net); PDK KLayout deck (FEOL+BEOL) 0 items on the 2x2 and
    on the 4x4; PVS LVS MATCH; Magic 4x4 DRC = baseline (840 abut + 32 capm.11, bot + the pre-existing met1.1 x4); Magic 21-port composition accepted.
    Supersedes edit20260922n/p/q, whose C1a move north (+0.8/+1.0) put the vsf MIM bottom arm over the photodiode (dnwell from y 3.28).
    - MIM plates: C1a capm 2.61-6.595 x 0.87-3.14 and C1b 9.12-10.625 as in production; C2 capm 1.20-2.20 (+0.33) with the vd met3 pa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
2026-09-22 openDVS pixel edit20260922r15a: round 15 — change-amp core vd/vdiff wiring trimmed, nRst run shielded by VddA18 instead of vdiff
    Layout-only on top of edit20260922r14d. KLayout flat LVS MATCH 61/80; PDK KLayout deck (FEOL+BEOL) 0 items on the 2x2 and the 4x4; PVS LVS MATCH;
    Magic 4x4 DRC = baseline (840 abut + 32 capm.11; bot + the pre-existing met1.1 x4).
    - t3: westmost gate contact of the change-amp input pfet dropped (licon/mcon 10.635-10.805 x 2.225-2.395), vd li row from 10.915 and vd met1 bar from
    10.935 (0.44 um instead of 0.1 from the vdiff met1 vertical).
    - t7: the vdiff met2 stub 9.96-10.385 cut above y 2.30 (only its via1 at 2.09-2.24 is needed).
    - t5: VddA18 met2 shield 11.18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
2026-09-22 openDVS pixel edit20260922r17b: round 17 — r15a pixel with a production-identical tile interface, extra GndD vias
    Layout-only. KLayout flat LVS MATCH 61/80 (flat 2x2 63 nets, GndD one net); PDK KLayout deck (FEOL+BEOL) 0 items on the 2x2 and the 4x4 and
    1466 items on the full pixel_4tile = the m baseline (1402 m1.3ab pre-existing + 64 met1.1 from the bot-context contact edit); PVS LVS MATCH;
    Magic 4x4 DRC = baseline. Supersedes r14d/r15a, whose row band (rowReadON 0.20-0.34, rowReadOFF 0.48-0.62, GndD 0.76-1.46 per row) was
    incompatible with the tile-level row interface (periphery stubs, GndD bar and tile pin squares at the production heights).
    - Inside the pixel the r15a layout is kept (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
2026-09-22 openDVS final GDS: r18b = r17b pixel merged into the submission wrapper with the foundry fixes, three MR-deck micro-fixes, DRC 0/0 and macro LVS match
    Merge of the edit20260922r17b pixel (6ccefa01) into the collaborators' user_project_wrapper.gds
    (ChipFoundry submission, Drive folder 1lnZ6a0QHfLVeT4IVGI0T_FX1_m-HIZ33): carries the foundry-side
    tap/fill/waffleDrop changes of the final pixel, drops their VddA18 well-tie strip (collides with the
    r17b GndA li and nRst feed) and four met2 density tiles, keeps the original contact$26 via cell.
    Micro-fixes for the precheck manufacturing-rule deck (psdm edge, GndD via, vd via pad + VddA18 shield).
    Verification: sky130A_mr.drc feol/beol 0/0 on pixel_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
    [band.py, capmgeom.py, celldiff.py, drcgeom.py, export2x2.py, hier.py, liwin.py, merge_final.py]
2026-09-23 openDVS final GDS: r19 = r18b pixel with GndD as a continuous met2 line per row, array-edge feeds adapted inside pixel_4tile (digital interface unchanged)
    r19_build.py: pixel west band back to r15a (straight row lines, GndD line from x 0), 2x2 overlay pins/labels at the band
    heights on both edge strips, biasgen_connector_v3 stubs jogged into the band, left_vdd_gnd_connectors GndD fed on met1
    east of the VddA18 tie rail with via pairs onto the lines, biasgen_connector_v2 (east) tongues + plate, tile-cell pin
    squares and port labels moved. sky130A_mr.drc on the wrapper's pixel_4tile: BEOL 0, offgrid 0, FEOL = baseline. PVS MATCH
    on the 2x2; test structure 'Circuits match uniquely'. Quantus cou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
2026-09-23 openDVS r19: tile LVS "Circuits match uniquely" (netgen on ini), precheck LVS/OEB stage = collaborators baseline, report and email as sent
    Claude-Session: https://claude.ai/code/session_01JTaRtVWQHDK9D8oKZ7XrHX
2026-09-23 openDVS pixel edit20260923r17c: contact$26$1$1 met1 back to the library cell (-0.160..0.155 um); the 2026-09-21 narrowing to -0.130..0.130 gave 64 MR_met1.WID.1 items on the tile
    Precheck deck sky130A_mr.drc BEOL on the pixel_4tile subtree: r17b 68 items (64 MR_met1.WID.1 + 4 m2.5) -> r17c 4 items (the 4 m2.5, fixed in the submission pixel by the r18b micro-fix). The submission wrapper already carries the original cell.
    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
    [revert_contact.py]
2026-09-23 final_merge r19: report adds the test-structure DRC, the wrapper-level power/pin connectivity (Magic + metal-only KLayout) and the tied-low test-pixel pixRst observation; trace scripts
    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
2026-09-23 final_merge r19: full cf_precheck rerun (all checks + Magic DRC vs the untouched final), power-connection renders, scripts
    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
2026-09-23 final_merge r20: wrapper-level same-net PDN joins (20 vdda1 met4 stripe extensions into the array, 20 vssa1 met5 stubs onto the GndA plane) built by r20_build.py from the verified r19; join planning/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
    r20 wrapper sha256 8d82a945 (r20/user_project_wrapper.r20.gds, untracked like r19). cf_precheck non-LVS 0/0, native BEOL deck 0 items, LVS report = r19 up to symmetric-class ordering, OEB as baseline.
    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
2026-09-23 final_merge r20: report (power-join effect from the lumped VddA18 model, r20 precheck/LVS results, bias-line assessment with index mapping, neighbour trace and PrBp injection test)
    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
2026-09-24 final_merge r21b: submitted GDS (xz + sha256), testbenches, tooling, audit
    - r21b/: user_project_wrapper.r21b.gds.xz (sha256 of the GDS fe196d31..., = the shuttle
    submission, project 2609800c) + SHA256SUMS; wrapper .gds files ignored (160 MB > GitHub limit)
    - testbenches/: crosstalk/reset bench (xtalk2/3, main.sp, r19 + production reset netlists),
    CACE runner (per-source roots, tables, datasheet-fix patch for CACE 2.5.6),
    r19 three-path PEX campaign tooling + manifest
    - audit_20260924/: full r21b audit (LVS mismatch classification + baseline LVS of the
    untouched original, macro-pin connectivity vs gate-level verilog, XOR by source,
    Magic DRC per rule, FEOL/offgrid, Magic antenna) +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
    [1x1array_tb.sch, BiasBranch.sch, BiasBranchBuffer.sch, BiasBranchnMaster.sch, BiasBranchnMasterx1.sch, BiasBranchnMasterx11.sch, BiasBuffers.sch, BiasCoarseBuffer.sch]
2026-09-26 xschem: track the dvs_readout_ctrl behavioral model; include it by relative path
    pixel_tb.sch and tb_PixelPhotoreceptor_dc(_2x2).sch place dvs_readout_ctrl.sym
    and .include dvs_readout_ctrl.spice, but the model lived only as an untracked
    file (and in the final_merge testbench snapshot), included by an absolute
    /home/rpgraca/... path. Add dvs_readout_ctrl.{va,sym,spice} to analog/xschem/
    (va/sym identical to the snapshot copies) and include it from the tcleval'd
    models block as [xschem get current_dirname]/dvs_readout_ctrl.spice, so the
    testbenches netlist in any checkout. Also ignore xschem's simulation/ and
    cace_sims/ output directories.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
    [pixel_tb.sch, tb_PixelPhotoreceptor_dc.sch, tb_PixelPhotoreceptor_dc_2x2.sch]
